minisystem/880/README.md

SYSTEM80 880
======================================

Analogue drum machine in Eurorack format. Currently under development.

Hardware design by Minisystem: info@system80.net

LICENSE
=======
cc by-nc-sa
https://creativecommons.org/licenses/by-nc-sa/4.0/
