minisystem/880/Manual/Page 15 - Specifications.pdf

Specifications | 15

## Rhythm Memory

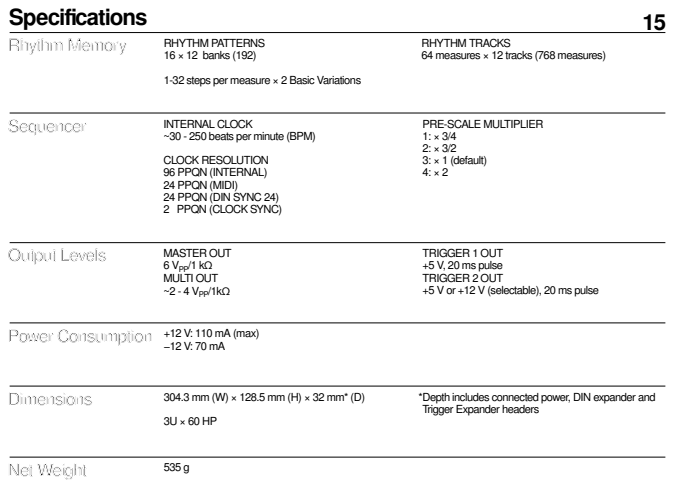
[picture p1: page 1]
Dimensions; Net Weight; Output Levels; MASTER OUT; 6 VPP/1 kΩ MULTI OUT ~2 - 4 VPP/1kΩ; Sequencer; INTERNAL CLOCK; PRE-SCALE MULTIPLIER 1: × 3/4 2: × 3/2 3: × 1 (default) 4: × 2

RHYTHM PATTERNS
16 × 12 banks (192)
1-32 steps per measure × 2 Basic Variations

RHYTHM TRACKS
64 measures × 12 tracks (768 measures)

~30 - 250 beats per minute (BPM)
CLOCK RESOLUTION
96 PPQN (INTERNAL)
24 PPQN (MIDI)
24 PPQN (DIN SYNC 24)
2 PPQN (CLOCK SYNC)

TRIGGER 1 OUT
+5 V, 20 ms pulse
TRIGGER 2 OUT
+5 V or +12 V (selectable), 20 ms pulse

Power Consumption +12 V: 110 mA (max)

epth includes connected power, DIN expander and
Trigger Expander headers
