minisystem/880/Panel/Panel_2.0_mechanical_r2000.dxf

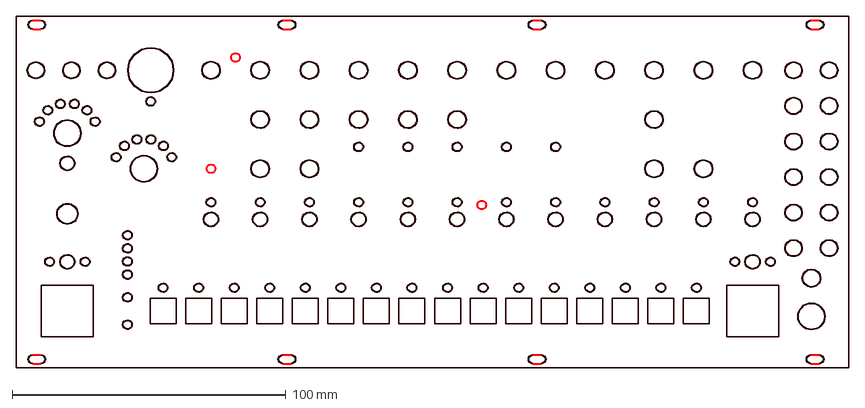
[picture p2: CAD file, 2017-06-20]
Panel/Panel_2.0_mechanical_r2000.dxf
304.3 x 128.5 mm
