minisystem/880/Panel/Panel_2.0_mechanical_r12.dxf

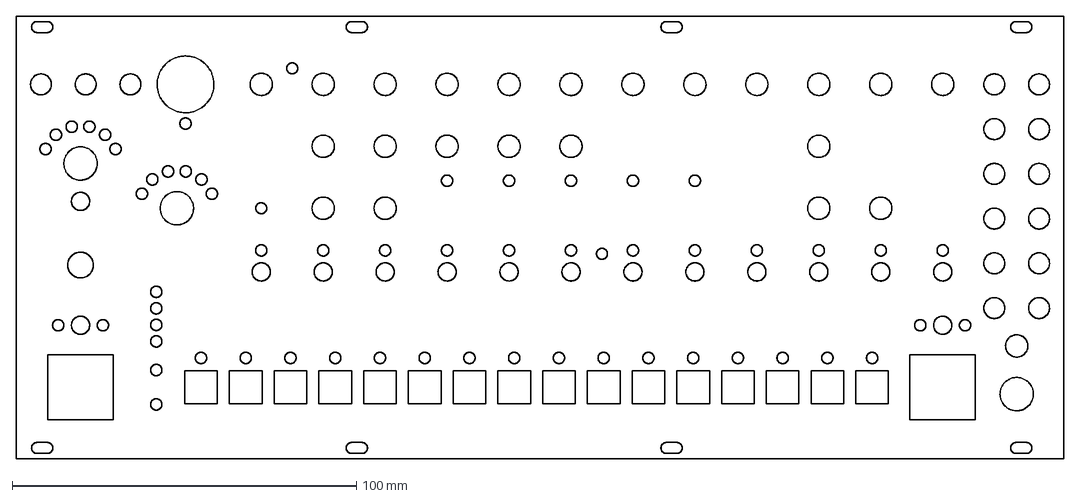
[picture p3: CAD file, 2017-06-20]
Panel/Panel_2.0_mechanical_r12.dxf
304.3 x 128.5 mm
