minisystem/880/Panel/Panel_2.0_mechanical.dxf

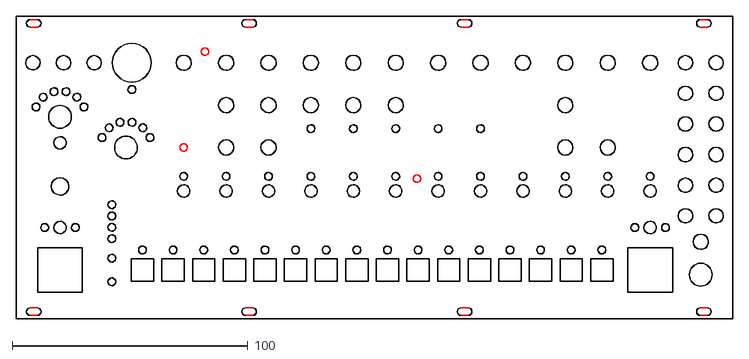
[picture p4: CAD file, 2016-09-16]
Panel/Panel_2.0_mechanical.dxf
304.3 x 128.5
