minisystem/880/Panel/79logo.dxf

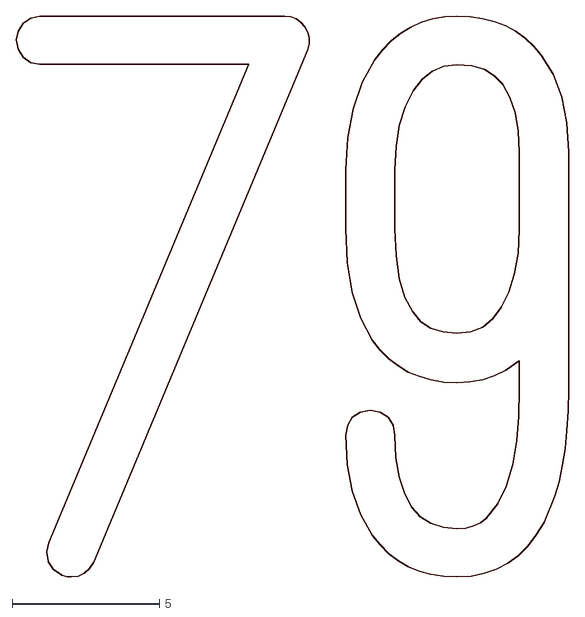
[picture p5: CAD file, 2016-09-08]
Panel/79logo.dxf
18.7 x 19.0
