minisystem/880/Panel/Panel 2.0 alignment template.dxf

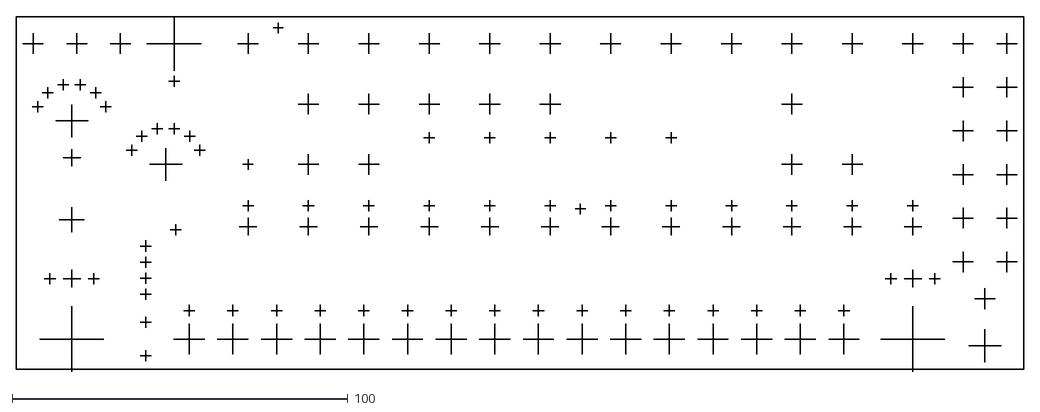
[picture p6: CAD file, 2016-09-03]
Panel/Panel 2.0 alignment template.dxf
300.0 x 105.8
