minisystem/880/Panel/Rhythm_composer_text.dxf

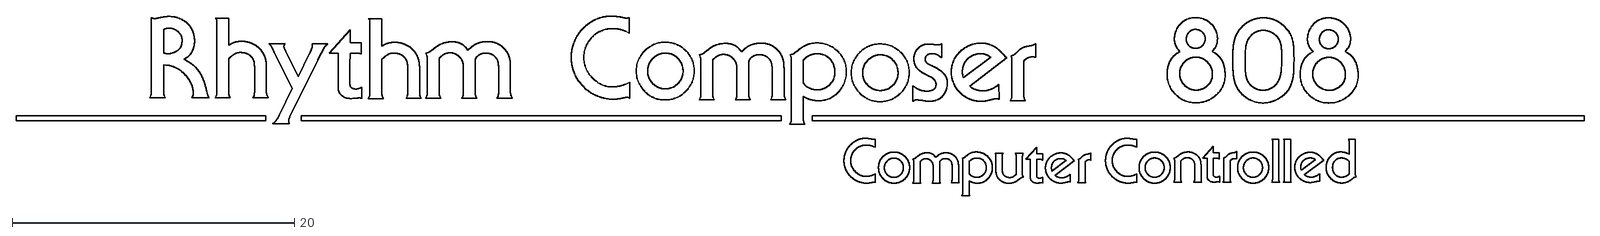
[picture p7: CAD file, 2016-09-03]
Panel/Rhythm_composer_text.dxf
111.1 x 12.7
