minisystem/880/Panel/Panel Template for import into Kicad.dxf

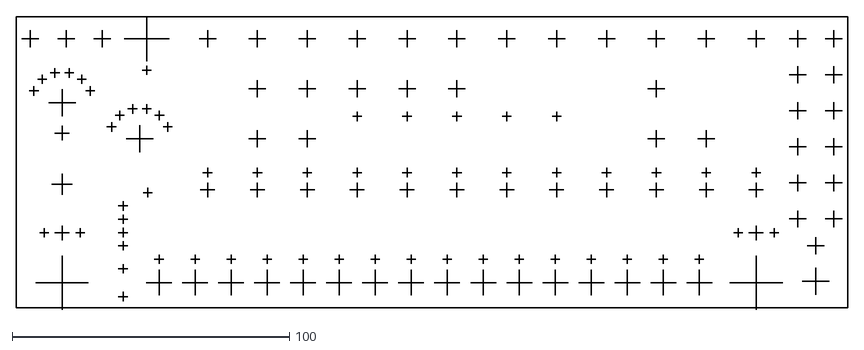
[picture p8: CAD file, 2016-07-31]
Panel/Panel Template for import into Kicad.dxf
300.0 x 105.8
