minisystem/880/Manual/Page 5 - Quick Tips.pdf

## Quick

Tips | 5
This section gives a quick overview of some of the enhanced features that are specific to the 880. If you are unfamiliar with how a TR-series step sequencer

## Change the MIDI Channel

The 880's MIDI receive channel is set to Channel 1 by default. To change the default MIDI receive channel, use the MODE selector button to select CLEAR mode. With the sequencer stopped, press and hold both the

SHIFT-WRITE/NEXT key and the ALT key. Use the STEP buttons to select the MIDI receive channel, from 1 to 16.

## Assign the Trigger Outputs

## Alternate the Basic Variations

The BASIC-VARIATION button toggles between Variation A and Variation B. To alternate between A and B press and hold the SHIFT-WRITE/NEXT key while pressing the BASIC-VARIATION button. To exit the alternating mode simply press the BASIC-VARIATION button once.

functions please start on the next page, Control Descriptions, and refer back to this section once you are familiar with the 880's step sequencer functions.

## Change the Pattern Bank

Press and hold the ALT key and use the STEP buttons to select one of the 12 Pattern Banks available.
NOTE: In MANUAL PLAY mode the SHIFT-WRITE/

In Pattern Edit Mode (1st PART or 2nd PART) the current Rhythm Pattern can be changed while the

Press and hold both the SHIFT-WRITE/NEXT key and the ALT key and select the desired Rhythm Pattern

The currently playing pattern will finish playing and the newly selected rhythm pattern will begin playing.

NEXT key needs to be used in combination with the ALT key to access the Pattern Banks.

The 880's two Trigger Outputs can be assigned to any of the 16 drum voices and the Accent trigger.
With the sequencer stopped, use the MODE selector button to select MANUAL PLAY. Use the I/F VAR switch to select Trigger 1 (A) or Trigger 2 (B). Press and hold the SHIFT-WRITE/NEXT key and the ALT key. While these keys are held the currently assigned trigger will be indicated by the Instrument/Track LEDs.

## Copy and Paste a Rhythm Pattern

In Pattern Edit mode (1st PART or 2nd PART), with the sequencer stopped, select the pattern you wish to copy. Press and hold the CLEAR button and then select a new pattern to copy to. Both VARIATION A and B will be copied to the destination pattern. Any pattern data in the destination pattern will be overwritten.

Use the Instrument/Track buttons to select the instrument you wish to assign to the Trigger Output. By default Trigger 1 is assigned to the Accent and Trigger 2 is assigned to the Cowbell. Trigger assignments are stored in non-volatile memory for recall after power off.

## Mute an Instrument

## Sync to an External Clock

## Copy Variation A to Variation B

In Pattern Edit mode (1st PART or 2nd PART), with Variation A set as the current variation, press and hold the CLEAR button and then press the BASIC-VARIAT-

ION button. The pattern data in Variation A will be copied to Variation B.

To mute an instrument, press and hold the SHIFT-WRITE/NEXT key and press the Instrument/Track selector button for the instrument you wish to mute. Press the selector button again to un-mute.

The 880 may be synced to external MIDI clock, DIN Sync24 clock or an analog clock pulse on the SYNC IN jack. Press the AUTO FILL IN selector button while holding down the SHIFT-WRITE/NEXT key to change the Synchronization Mode.

Refer to Synchronization on Page 12 for more information.
