minisystem/880/Manual/Page 9 - Playing Rhythm Patterns.pdf

## Manual Play

## Playing Rhythm

Patterns | 9
MANUAL PLAY mode is a performance mode that allows Rhythm Patterns to be selected and played in real time. Fill In rhythms can be programmed to play at intervals or manually using the TAP button.
With the sequencer stopped, press the MODE selector button to select MANUAL PLAY mode. The STEP buttons are divided into two groups, 12 BASIC RHYTHMs and 4 INTRO/FILLs. The currently selected BASIC RHYTHM will blink in time with the tempo and the currently selected INTRO/FILL LED will remain solid.
Press the START/STOP button. The sequencer will begin to play the selected BASIC RHYTHM pattern. While the sequencer is playing, select a new BASIC

RHYTHM pattern. When the current pattern finishes playing the new pattern will start to play. If you wish to change the current Pattern Bank, press and hold the SHIFT-WRITE/NEXT key and the ALT key and select one of the 12 Pattern Banks using the STEP buttons. NOTE: MANUAL PLAY mode is the only mode where the SHIFT-WRITE/NEXT key needs to be used in combination with the ALT key to change the Pattern Bank.
The BASIC VARIATION button can be used to select the desired rhythm variation, A or B. Hold the SHIFT-WRITE/NEXT key and press the BASIC VARIATION button to enter the alternating A-B mode.

## Adding Intros and Fill Ins

You may add an introductory Rhythm Pattern that plays only once after the sequencer starts and is then followed by the selected BASIC RHYTHM pattern. With the sequencer stopped, press the TAP button. The selected BASIC RHYTHM LED will become solid and the selected INTRO/FILL IN LED will flash. This indicates that the Intro pattern is active and will play before the BASIC RHYTHM pattern when the sequencer is started. To cancel the Intro function, press the TAP button again. The selected BASIC RHYTHM LED will begin flashing and the INTRO/FILL IN LED will remain solid.
A Fill In Rhythm Pattern can be inserted between the BASIC RHYTHM pattern manually or at a programmed number of measures. To manually insert a Fill In rhythm, set the AUTO FILL IN selector to MAN and start the sequencer. The currently selected BASIC RHYTHM will begin to play. While the sequencer is playing press the TAP button. The currently playing BASIC RHYTHM will finish and the selected INTRO/ FILL IN pattern will play once. Pressing the TAP button again before the Fill In pattern finishes will make it play again.
If the BASIC VARIATION mode is set to alternate between variation A and B then pressing the TAP button will replace the next variation with the Fill In rhythm pattern. For example, if variation A is playing and the TAP button is pressed, then the Fill In will replace the queued B variation and return to the A variation.

Normal variation sequence:

VAR A | VAR B | VAR A
Sequence with Fill In:
VAR A [TAP] | FILL IN | VAR A
The same holds true if the TAP button is pressed again to repeat the Fill In.
Normal variation sequence:
VAR A | VAR B | VAR A | VAR B
Sequence with Fill In:
VAR A [TAP] | FILL IN [TAP] | FILL IN | VAR B
Fill Ins can also be programmed to occur automatically by setting the AUTO FILL IN selector to the desired interval number. The Fill In rhythm Pattern can be programmed to play every 2nd, 4th, 8th, 12th and 16th measure, automatically. To cancel automatic Fill Ins, set the AUTO FILL IN selector to MAN.
An Intro or Fill In's BASIC VARIATION can be selected using the I/F VAR button.
NOTE: in all other modes the I/F VAR button functions as the ALT key. To access the ALT key function in MANUAL PLAY mode you must also press the SHIFT-WRITE/NEXT key.

## Auditioning Drum Hits

In MANUAL MODE the Instrument Selector buttons can be used to trigger the drum voices. This allows the different drum sounds to be audtioned to try out rhythms in real-time and can also be used to improvise over top of a currently playing Rhythm Pattern.
Live drum hits can only be triggered in MANUAL
MODE when Audition Mode is activated. To activate Audition Mode, press and hold the SHIFT/WRITE-NEXT key and press STEP 7 ([AUD]). The STEP 7 LED will light indicating that Audition Mode is active. You may now use the Instrument Selector buttons to trigger the drum voices.

The paired instruments are accessed by switching between the A and B INTRO/FILL IN mode. When the INTRO/FILL IN mode is set to A, the bottom row of instruments are triggered and when the INTRO/FILL IN mode is set to B, the top row of instruments are triggered.
When Audition Mode is active, you lose the ability to select the current instrument for rolls. To disable Audtion Mode, press and hold the SHIFT/WRITE-NEXT key and press STEP 7 again to disable drum auditioning.
