minisystem/880/Manual/Page 17 - Operation Reference.pdf

Operation Reference | 17

## Rhythm Pattern Programming

### 1 With the sequencer stopped, set the MODE selector to

PATTERN CLEAR.

2
Press the BASIC VARIATION button to select Variation A or Variation B. ³
Press the CLEAR button.
Set the MODE selector to 1st PART.

4

Start the sequencer by pressing the START/STOP button.

5

6
While pressing the SHIFT/WRITE-NEXT key, press the CLEAR button to choose the PRE-SCALE. ⁷
While pressing the CLEAR button, press a STEP button to set the desired pattern length (1-16)*. ⁸
Choose an instrument using the INSTRUMENT/TRACK selector buttons. ⁹
Press the STEP buttons to program the instrument on the desired steps. ¹⁰
Program the other instrument sounds and ACCENT by repeating and . 9 10 11
Press the START/STOP button when programming has been completed.

## Manual Play

1

### 2 Use STEP buttons 1-12 to select the Basic Rhythm

Pattern you want to play.

3

4

Set the MODE selector to MANUAL PLAY.

Press the BASIC-VARIATION button to select the Variation you want to play, A or B.

## Intro

Use STEP buttons 13 - 16 to select the Intro Rhythm Pattern you want to play. ¹

2
3 Press the TAP button to activate the Intro.

## Fill In (MANUAL)

1 Set the AUTO FILL IN selector to MAN.

4

Press the I/F - VAR button to select the Intro variation.

3 Press the I/F - VAR button to select the Fill In variation.

### 4 Press the TAP button when you want the Fill In Rhythm

Pattern to play instead of the BASIC RHYTHM.

### 2 Use STEP buttons 13 - 16 to select the Fill In Rhythm

Pattern you want to play.

Start the sequencer by pressing the START/STOP button.

Start the sequencer by pressing the START/STOP button.

12

Use the STEP buttons to select the Rhythm Pattern memory location you wish to program.

In the case of programming 16 steps setting the pattern length is unnecessary.

*

## Fill In (AUTOMATIC)

### 1 Choose the Fill In count using the AUTO FILL IN selector

(16, 12, 8, 4, or 2 measures).

3 Press the I/F - VAR button to select the Fill In variation. 4 Press the START/STOP button to start the sequencer.

### 2 Use STEP buttons 13 - 16 to select the Fill In Rhythm

Pattern you want to play. Track Compose

1

### 2 Choose the Track with the INSTRUMENT/TRACK

selector buttons.

3

4

Set the MODE selector to COMPOSE

Use the STEP buttons to select the first Rythm Pattern of the Track.

## Track Play

1 Set the MODE selector to PLAY.

2

3

4

Choose the Track to play using the INSTRUMENT/ TRACK selector buttons.

Start the sequencer by pressing the START/STOP button.

Press the BASIC VARIATION button to select Variation A or Variation B. ⁵
6 Press the START/STOP button to start the sequencer. Press the SHIFT-WRITE/NEXT key to advance to the next measure. ⁷
Use the STEP buttons to select a different Rythm Pattern, if desired. Press the SHIFT-WRITE/NEXT key to save the Rhythm Pattern and advance to the next measure.

8

9

Press the CLEAR button.

At the last measure of the composition, stop the sequencer by pressing the START/STOP button.

Press the BASIC VARIATION button to select Variation A or Variation B.
