minisystem/880/Manual/Page 18 - Back Cover.pdf

## SYSTEM80

Toronto, Ontario, Canada

System80 Inc.
