minisystem/880/Manual/Page 16 - Warranty.pdf

Warranty | 16

## Contact

Open Source | The 880 is open source hardware and the firmware is open source software. This means the complete design is available for non-commerical use. If your 880 ever requires an out-of-warranty repair, the design files
Warranty | Your 880 is guaranteed to be free from manufacturing defects for 1 YEAR from the date of purchase. At our sole discretion we will replace or repair your unit if we find it to be defective (transport charges may apply). NOTE: the 880's panel is screenprinted in 3 colours of

Do not hesitate to contact System80 with any questions or concerns about your 880. The 880 began as a passion project with the aim of making a small recreation of the TR-808 in Eurorack with as few compromises as possible. It was a lot of fun to design, prototype, and test. We hope that it will inspire you for many years.

durable epoxy-based ink. It is a 5 step process that is performed manually. Being a hand crafted product, you may notice very small blemishes or defects upon close inspection. These are unavoidable and inherent to the manual painting and screenprinting process.

YouTube, and Muffwiggler, these are not the best ways to reach us with questions or concerns about your 880. We endeavor to respond to email inquiries within 48 hours of receiving them.

Please contact us by email:
info@system80.net
While System80 has a regular presence on social media sites such as Facebook, Instagram, Twitter,

should allow a local qualified technician to perform any repair or modification.

www.github.com/minisystem/880
