minisystem/880/880_main.pdf

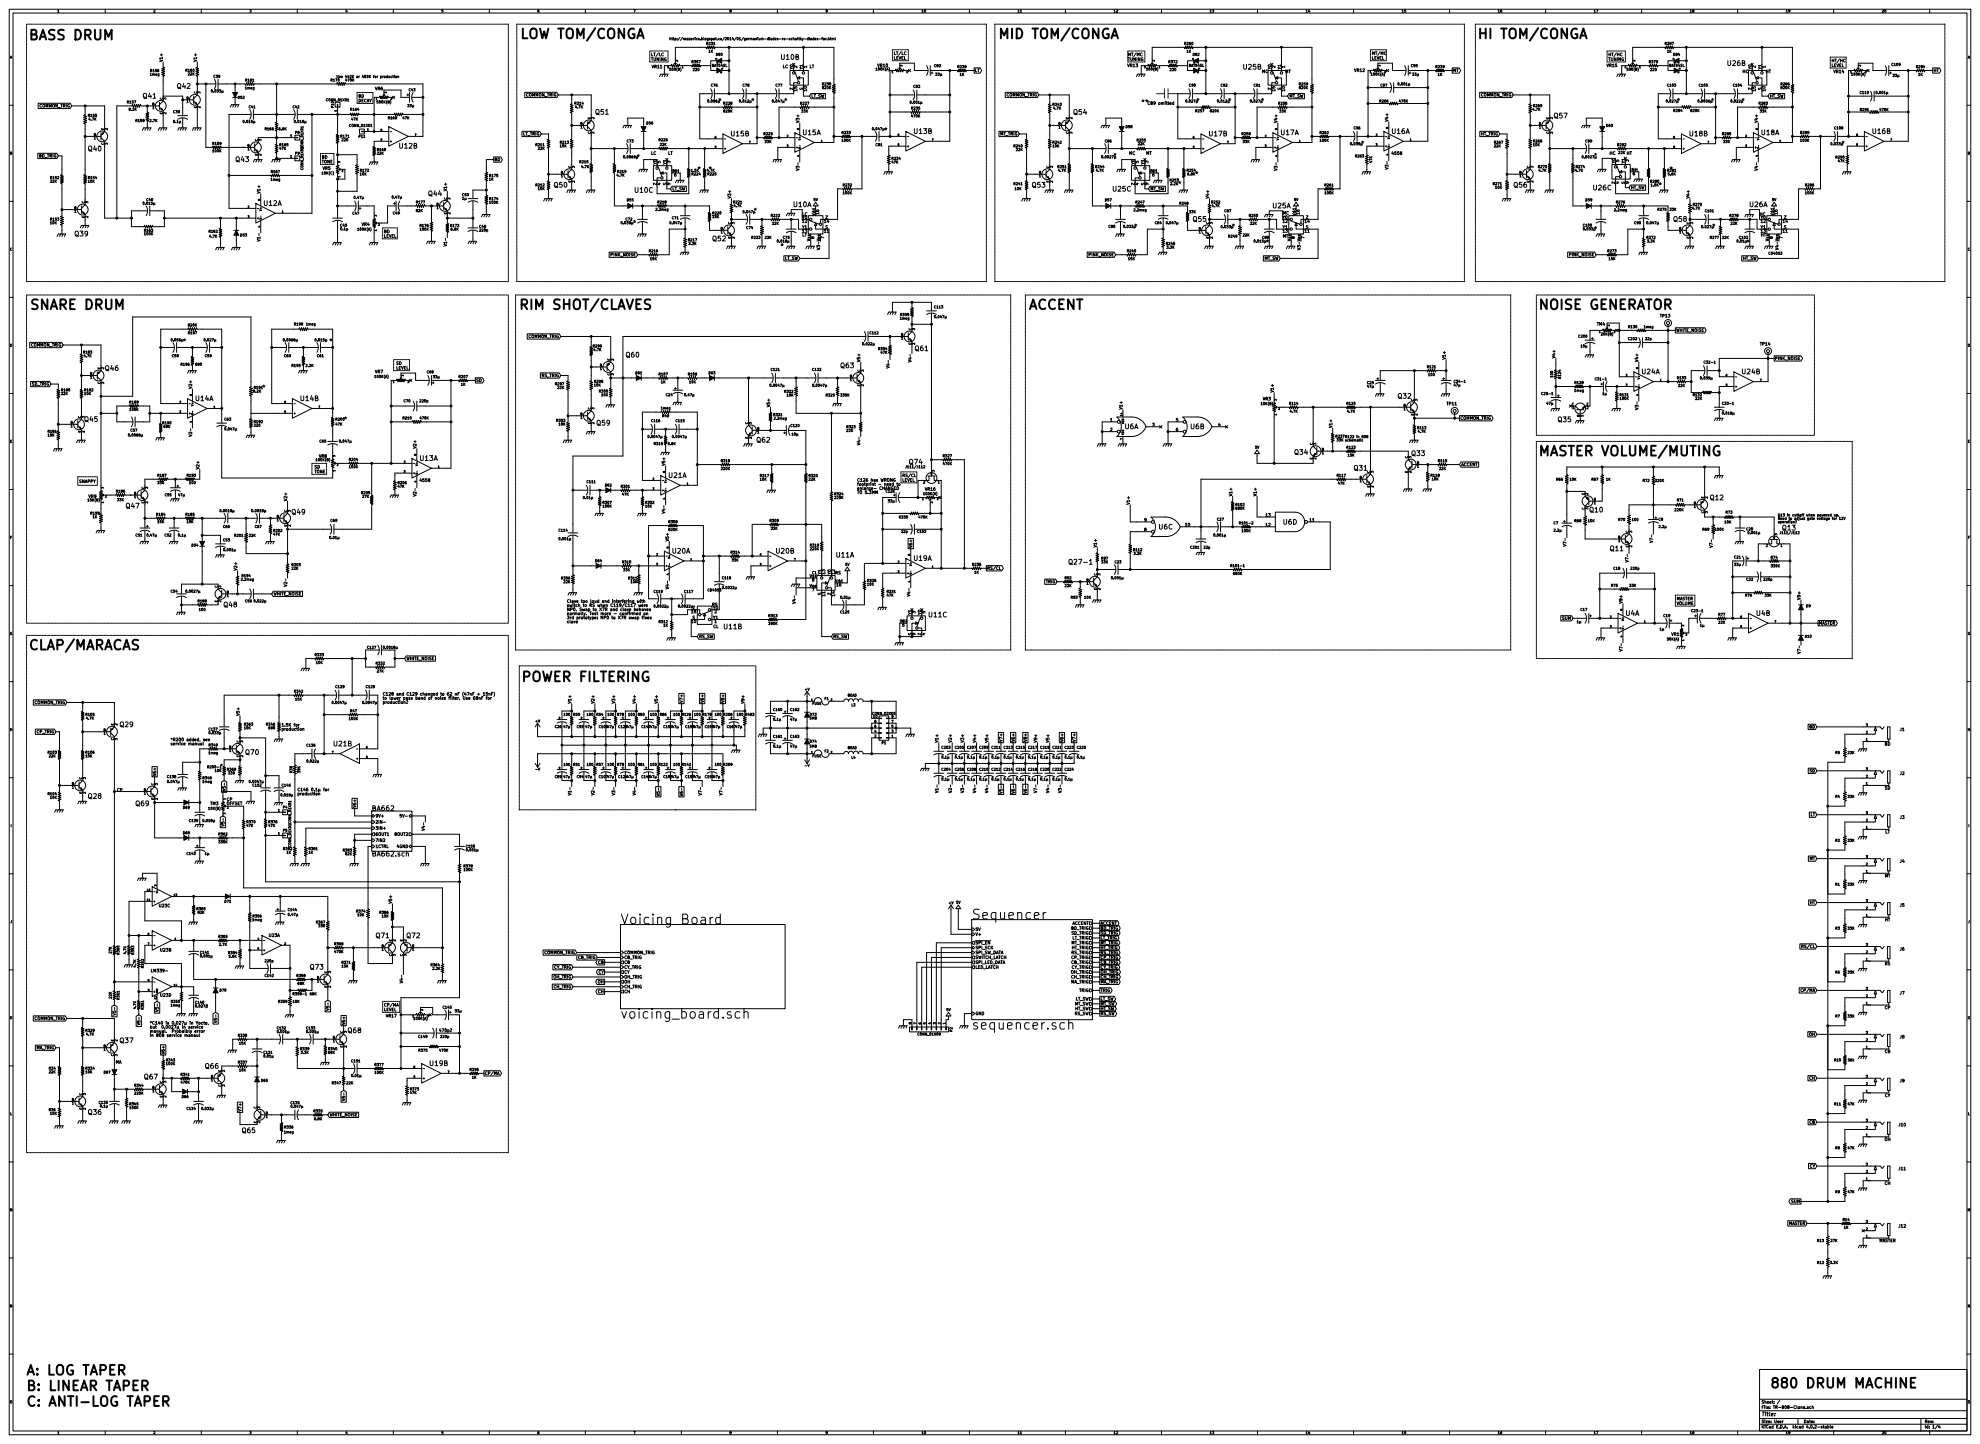
[picture p11: page 1]

Use 442K or 453K for production

Q13 in cuttoff when powered up.
Need to adjust gate voltage for 12V
operation?

Clave too loud and interfering with
switch to RS when C119/C117 were
NP0. Swap to X7R and clave behaves
normally. Test more - confirmed on
3rd prototype: NP0 to X7R swap fixes
clave

to lower pass band of noise filter. Use 68nF for
production?

*C140 is 0.027 in Yocto, but 0.0027 in service manual. Probalbly error

Id: 1/4 Title: File: TR-808-Clone.sch Sheet: /
