minisystem/880/880_voicing.pdf

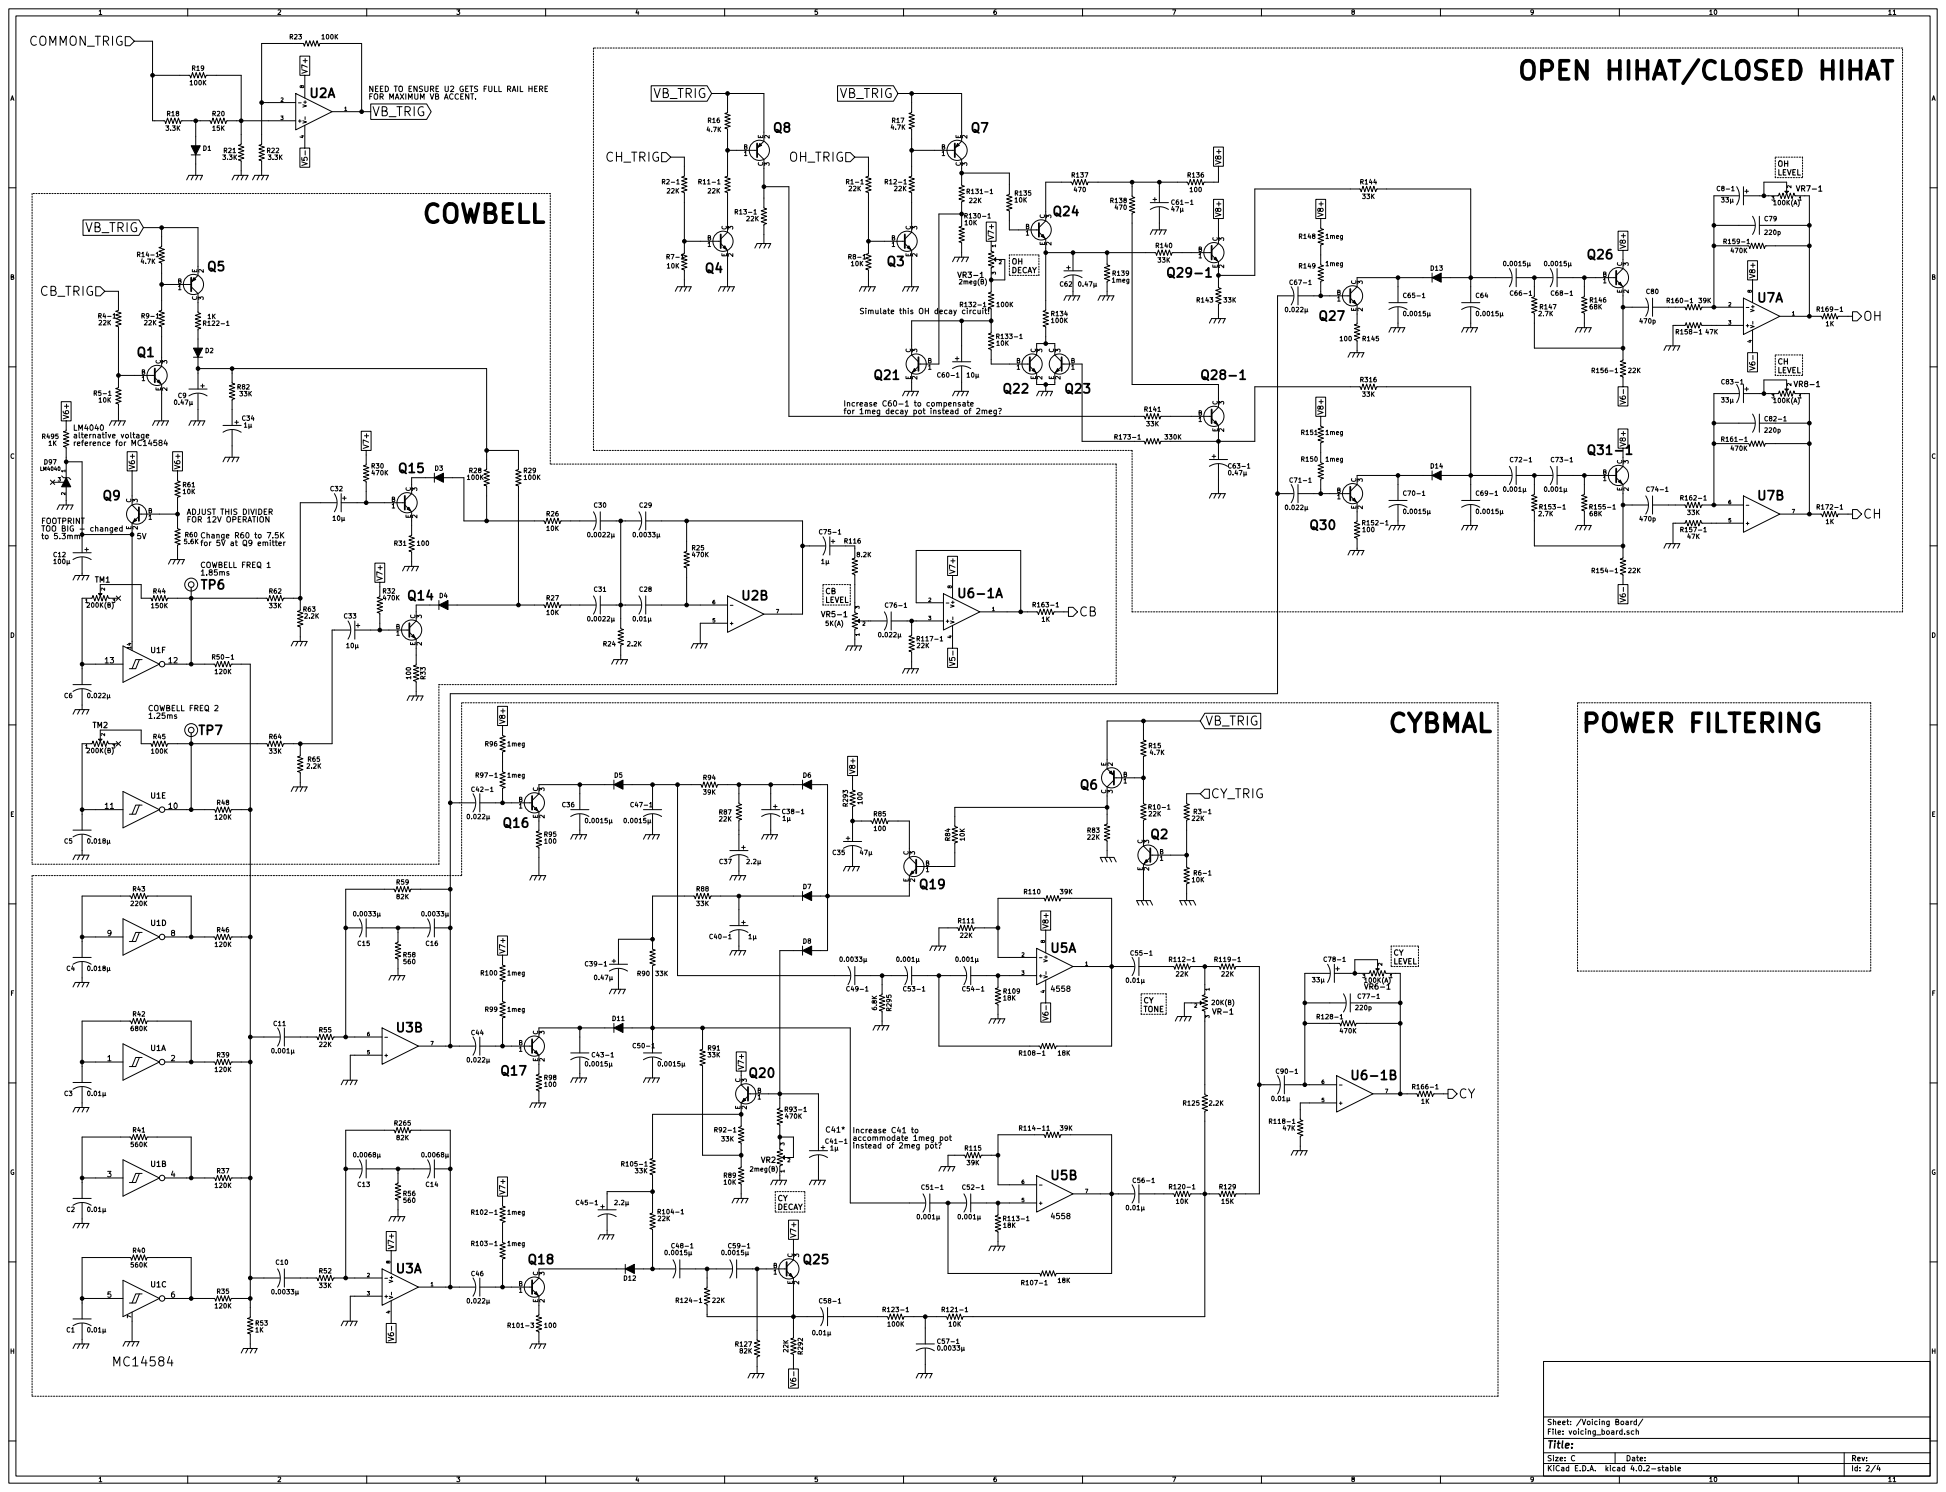
[picture p12: page 1]

OPEN HIHAT/CLOSED HIHAT

22K NEED TO ENSURE U2 GETS FULL RAIL HERE
FOR MAXIMUM VB ACCENT.

Simulate this OH decay circuit! R2-1

Increase C60-1 to compensate
for 1meg decay pot instead of 2meg?
