minisystem/880/Manual/Page 2 - Front Panel Layout.pdf

## SYNC INPUT MIDI INPUT

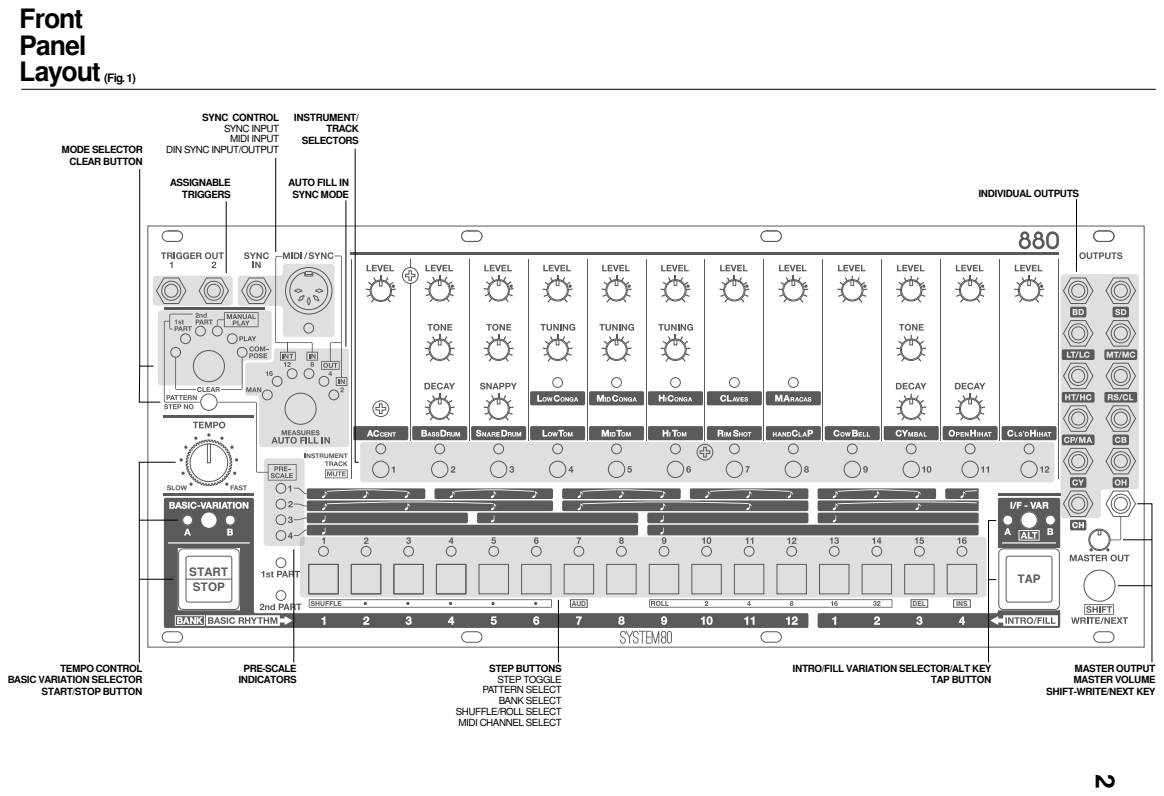
[picture p13: page 1]
(Fig. 1); AUD; DEL; INS; TAP START STOP; ASSIGNABLE TRIGGERS; MODE SELECTOR CLEAR BUTTON; INSTRUMENT/ TRACK SELECTORS; TEMPO CONTROL; PRE-SCALE INDICATORS; SYNC CONTROL; TAP BUTTON; INDIVIDUAL OUTPUTS; Front Panel Layout

DIN SYNC INPUT/OUTPUT

AUTO FILL IN
SYNC MODE

STEP BUTTONS
STEP TOGGLE
PATTERN SELECT
BANK SELECT
SHUFFLE/ROLL SELECT
MIDI CHANNEL SELECT

INTRO/FILL VARIATION SELECTOR/ALT KEY

MASTER OUTPUT
MASTER VOLUME
SHIFT-WRITE/NEXT KEY

BASIC VARIATION SELECTOR

START/STOP BUTTON
