minisystem/880/Panel/808-panel-April.pdf

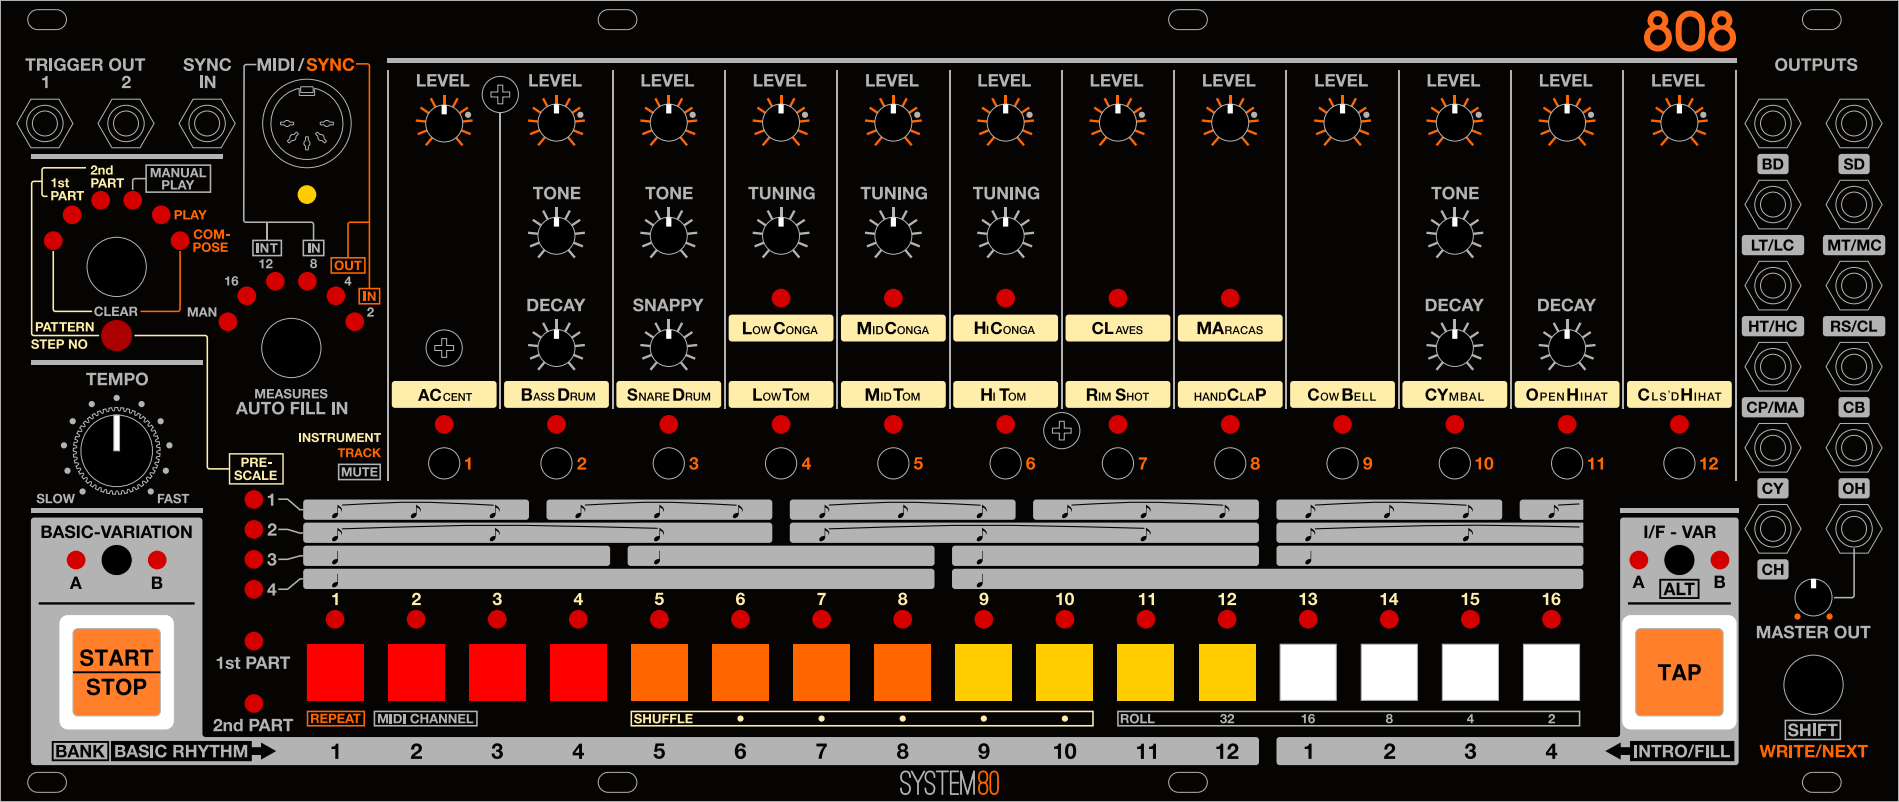
[picture p14: page 1]
