minisystem/880/Panel/Euro TR-808 Panel.pdf

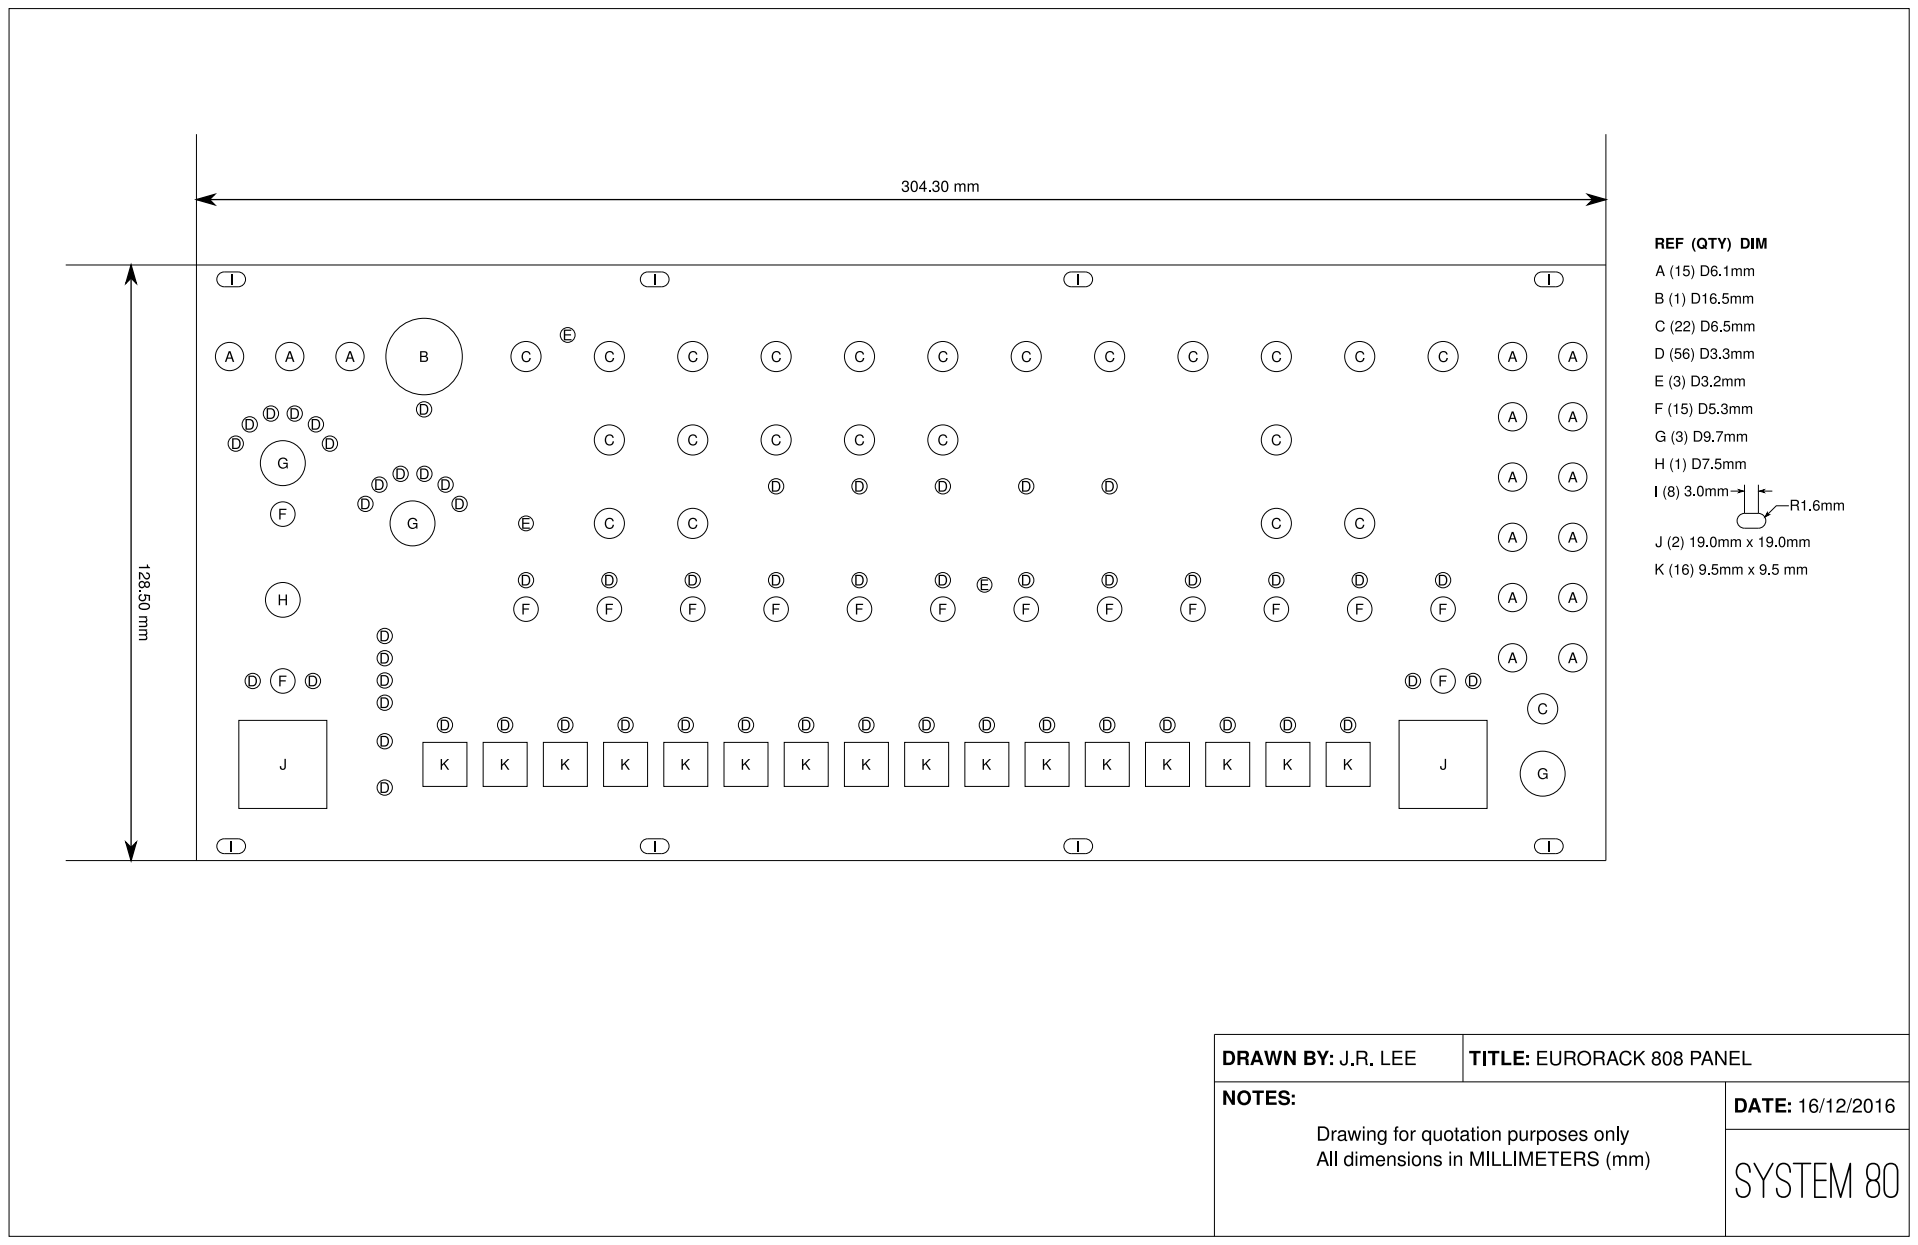
[picture p15: page 1]
