minisystem/880/Manual/Quick Guide - Inside - no fold lines.pdf

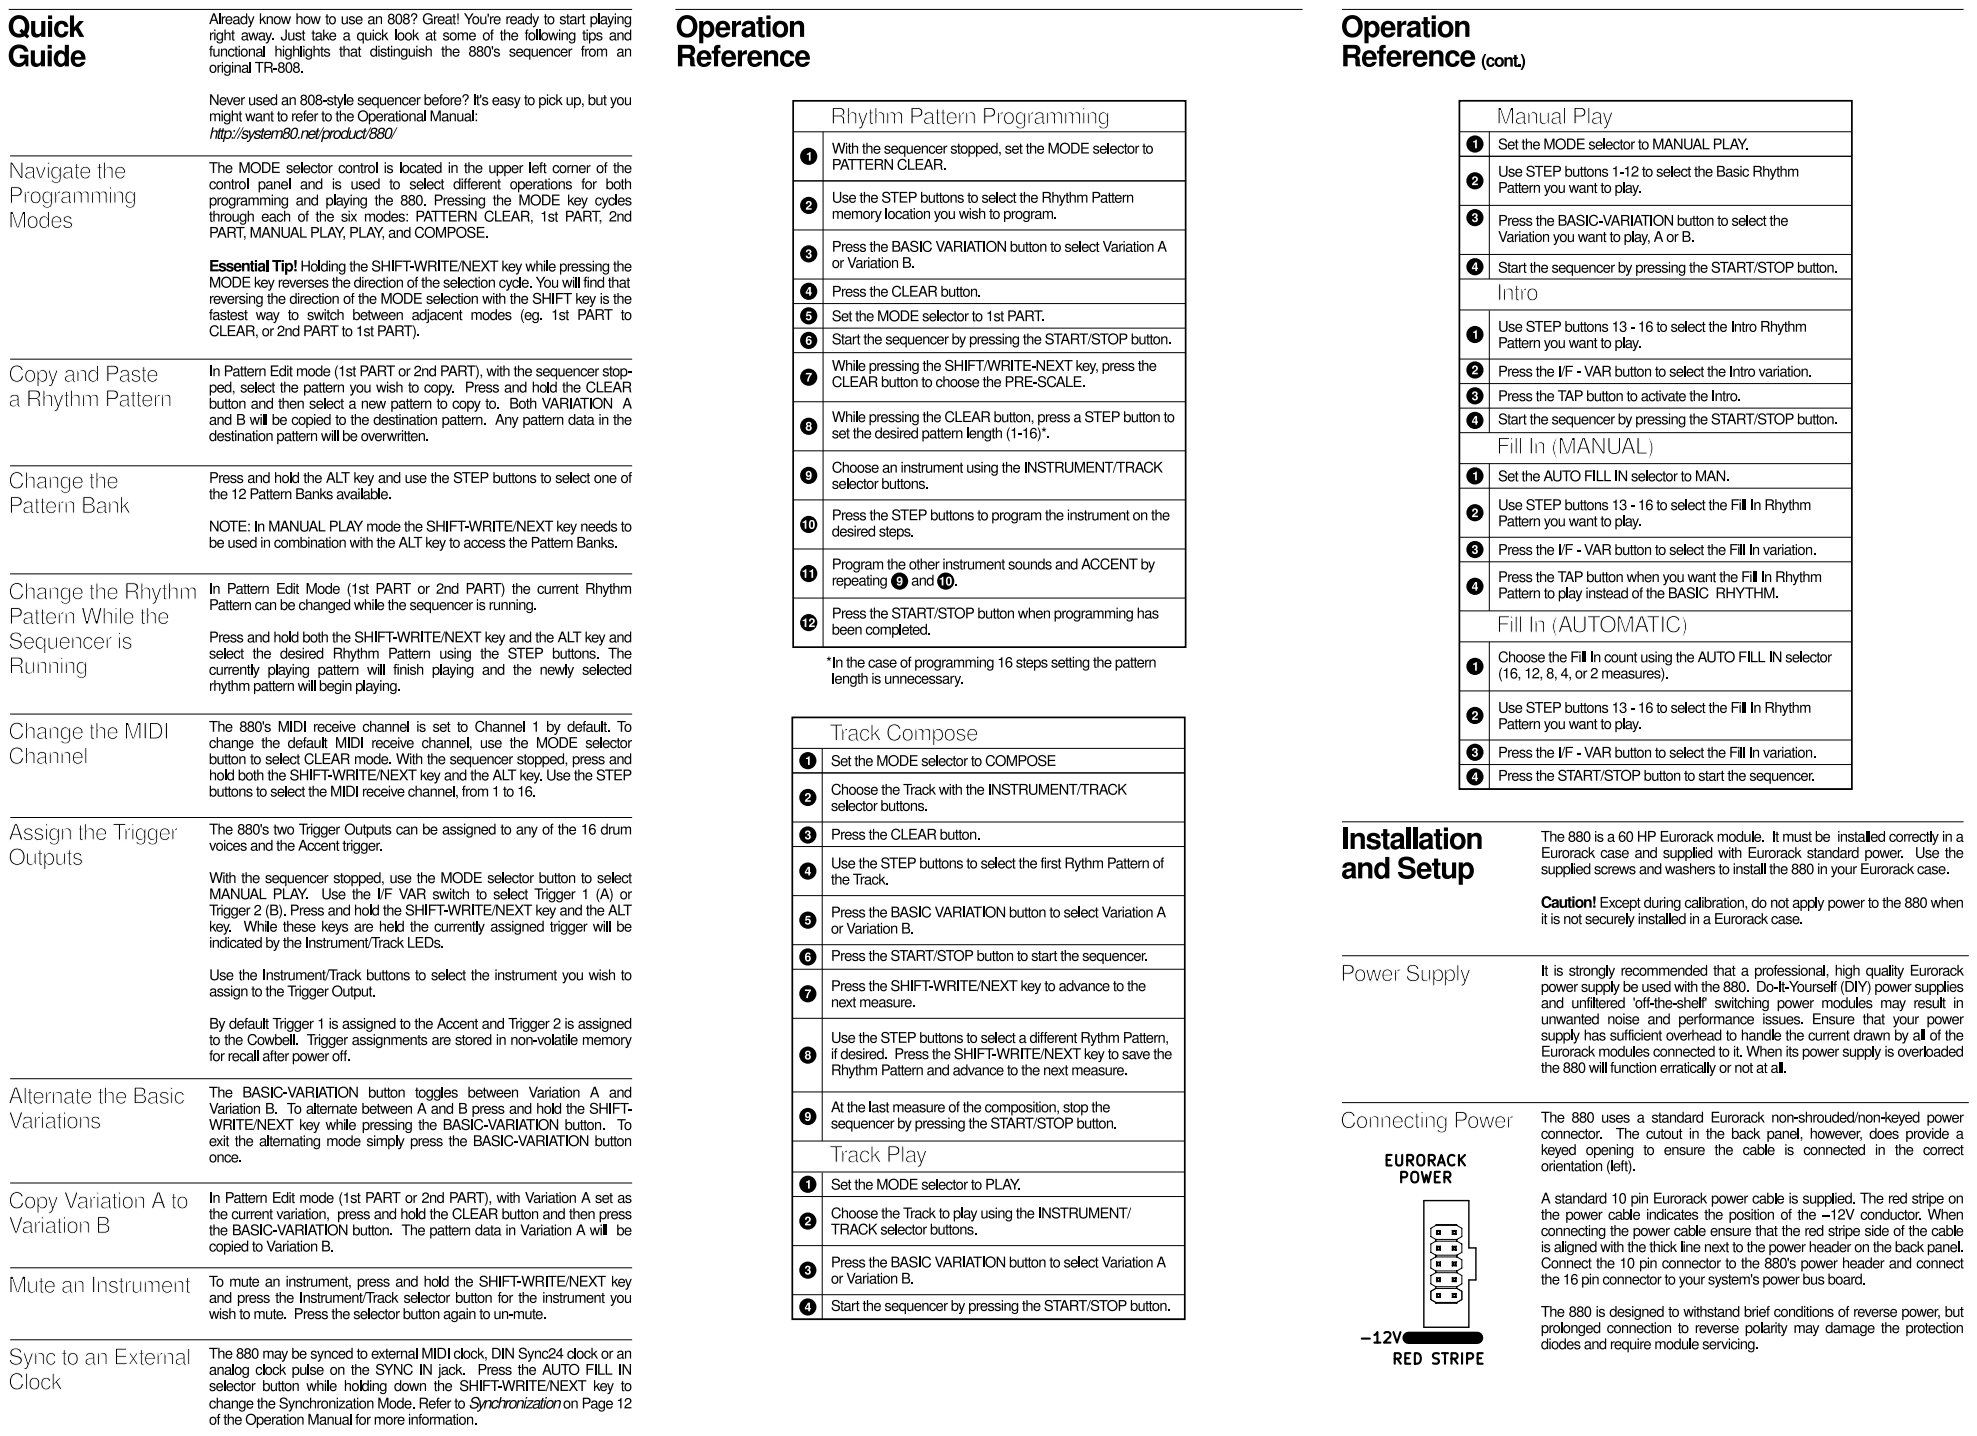
[picture p16: page 1]
