minisystem/880/Manual/Quick Guide - Inside.pdf

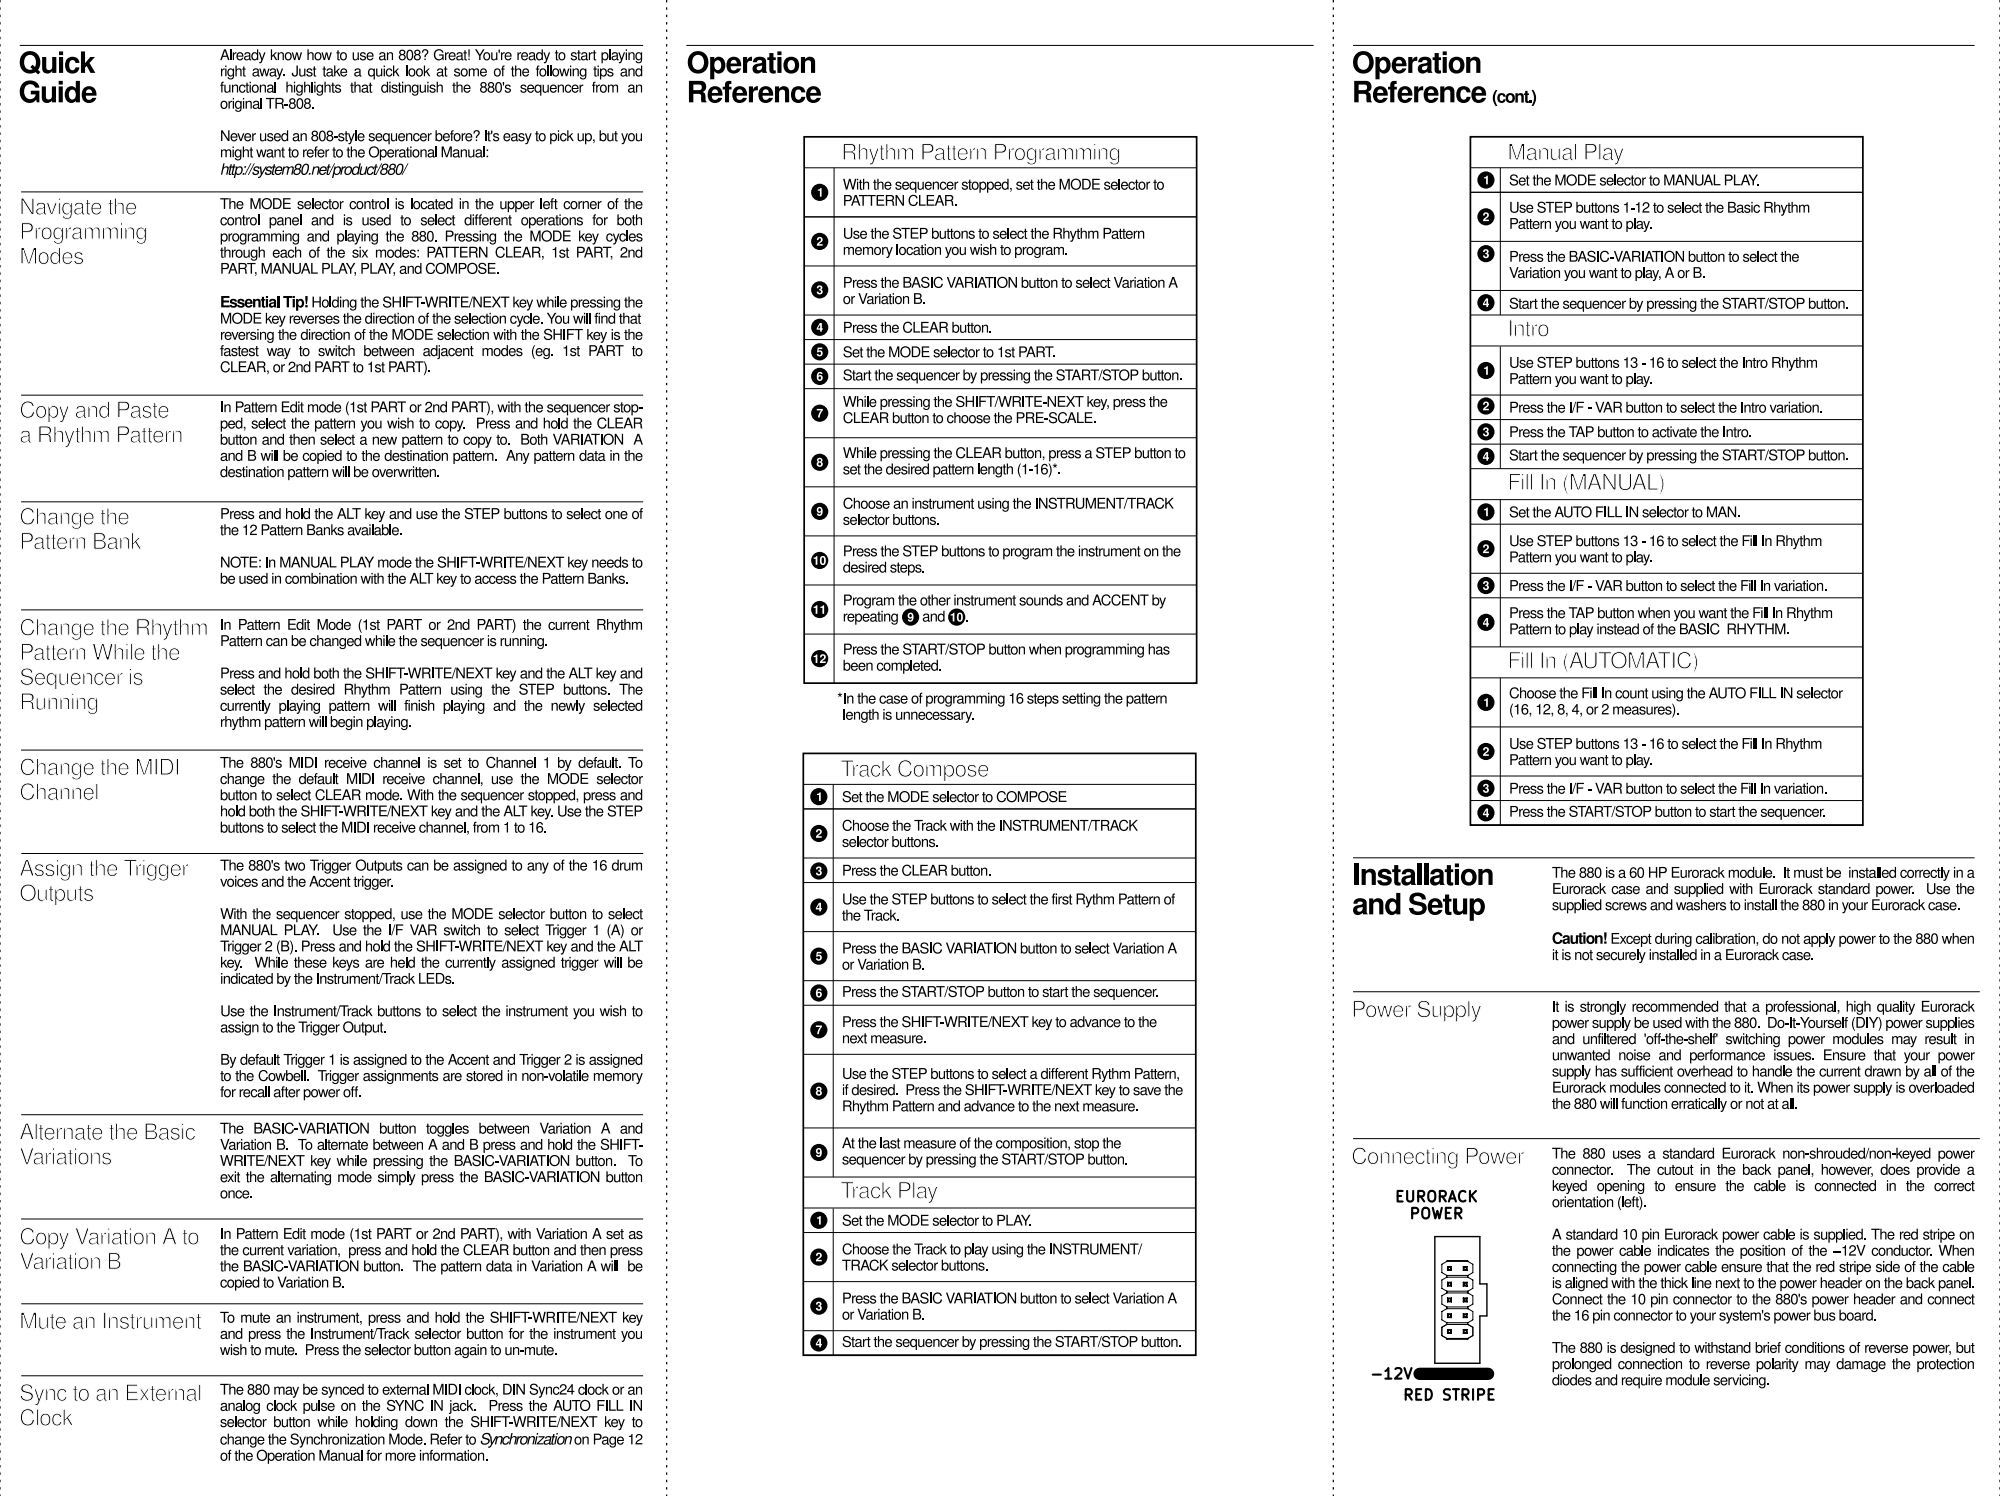
[picture p17: page 1]
