minisystem/880/Manual/Quick Guide - Outside - no fold lines.pdf

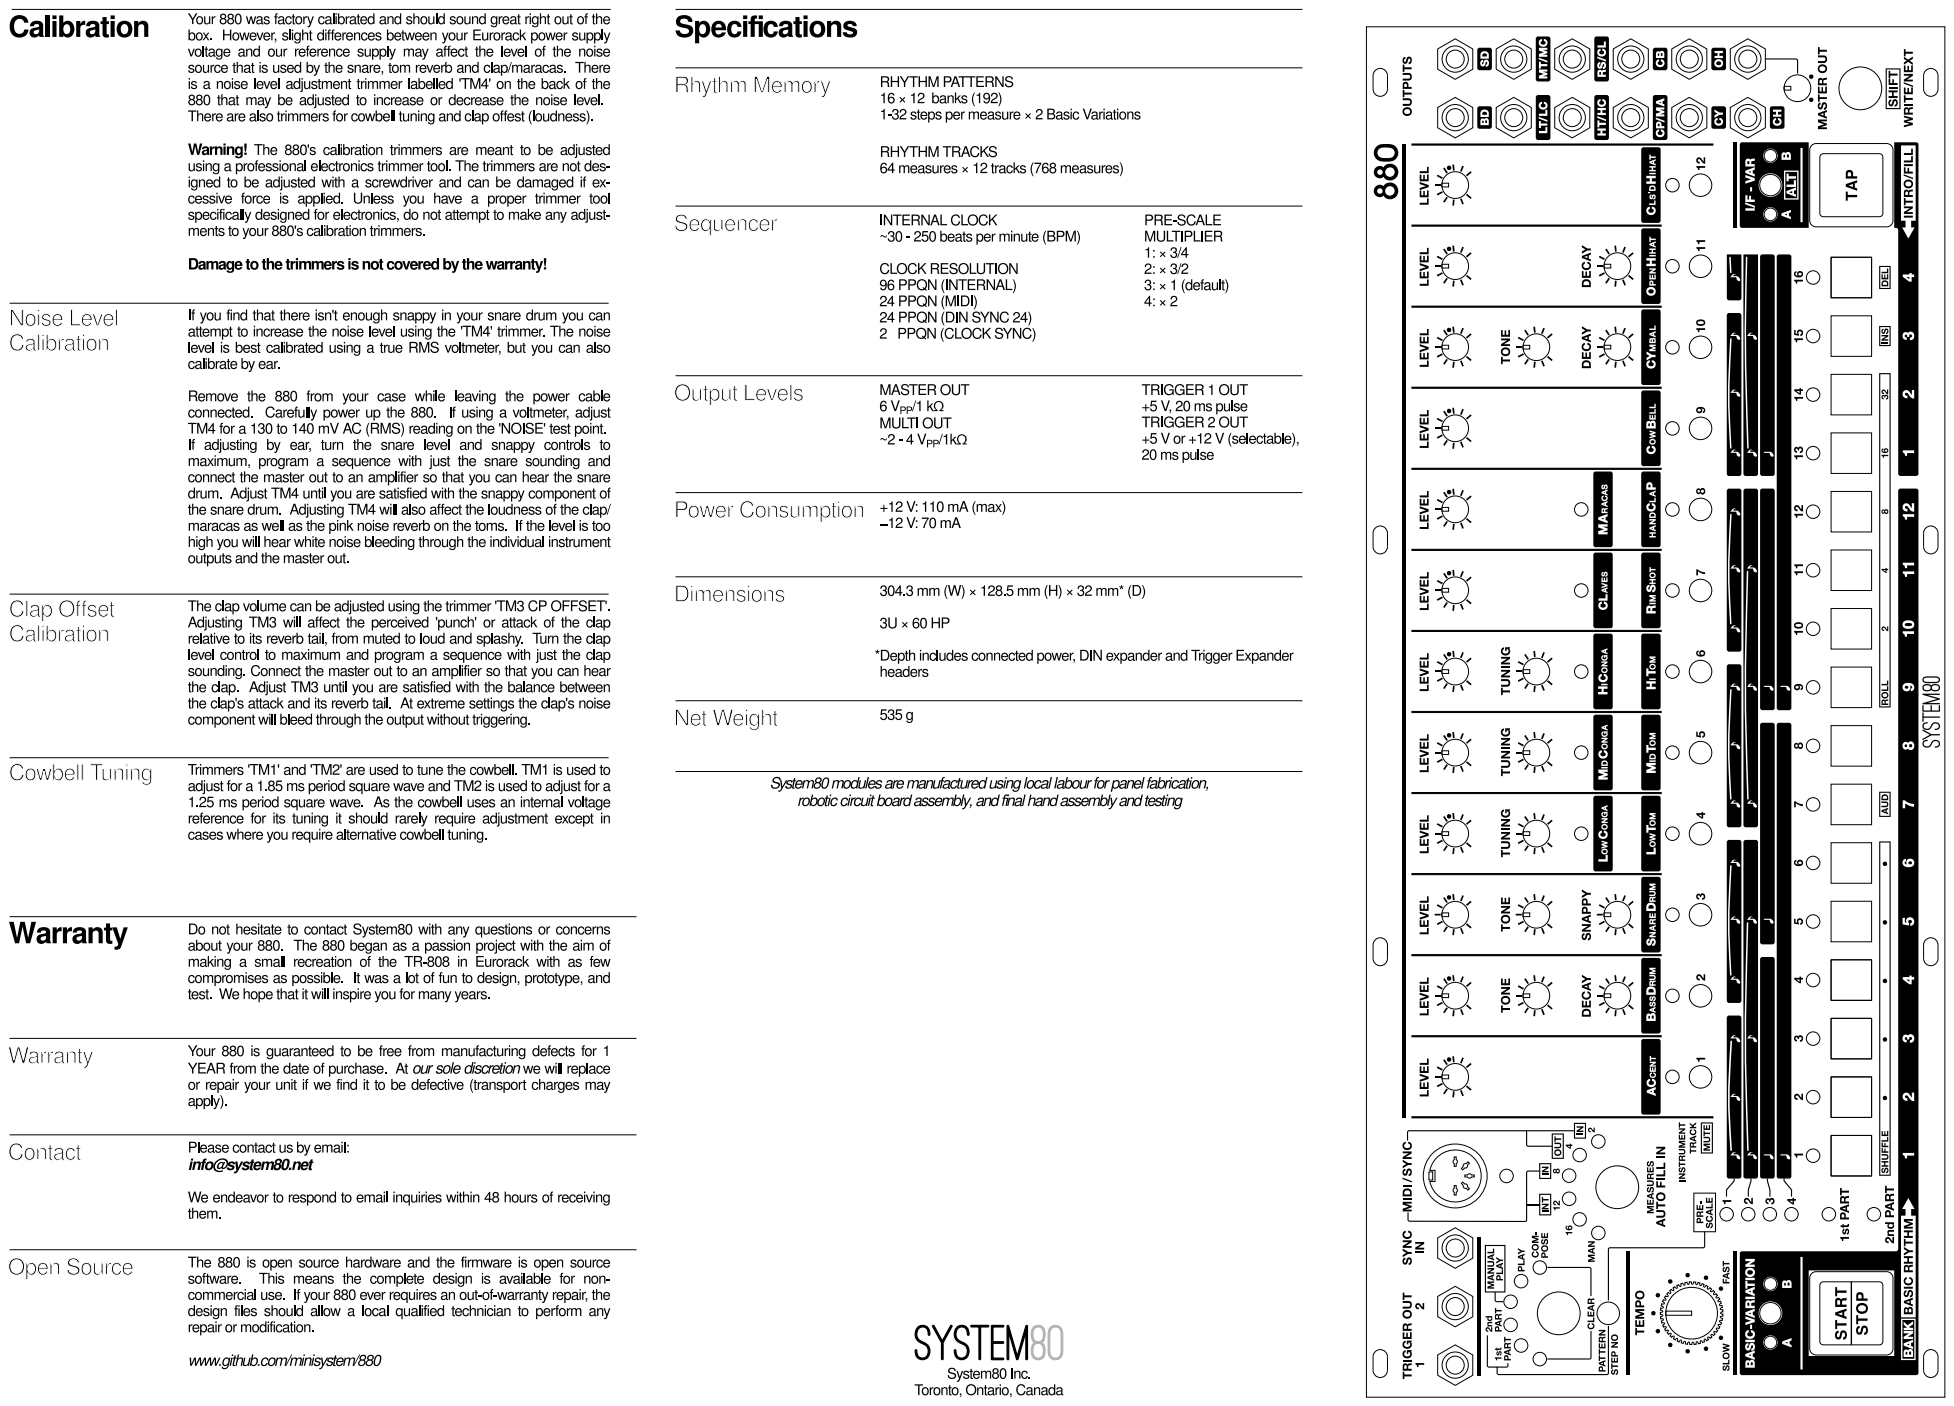
[picture p18: page 1]
