minisystem/880/Manual/Quick Guide - Outside.pdf

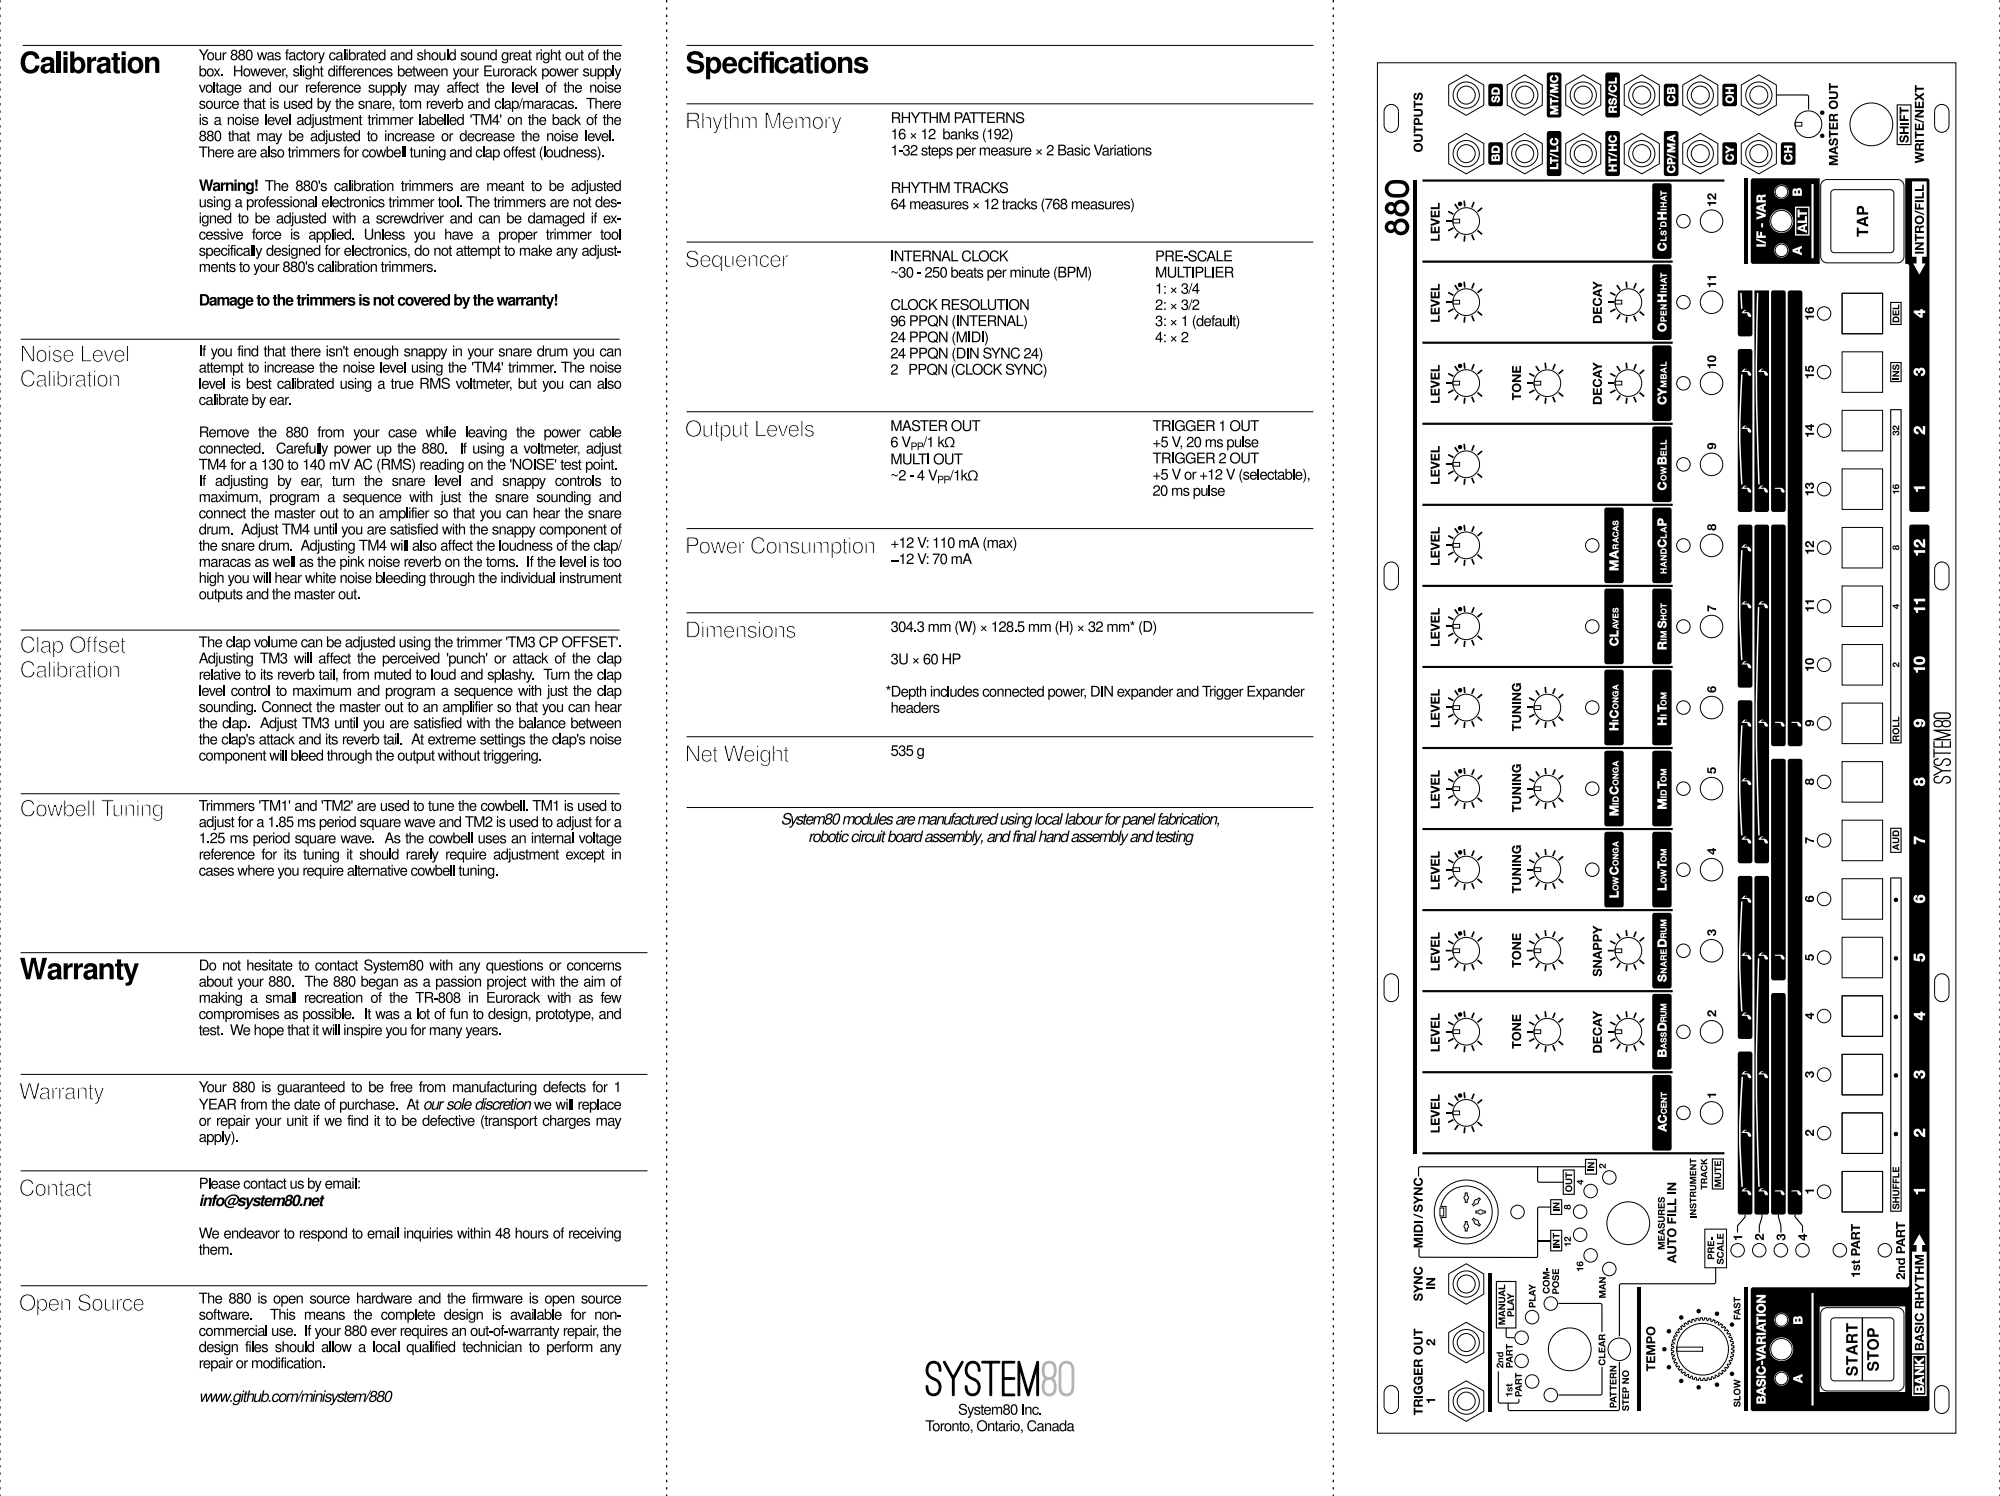
[picture p19: page 1]
