minisystem/880/Manual/Cover - Front.pdf

## Operation Manual

880

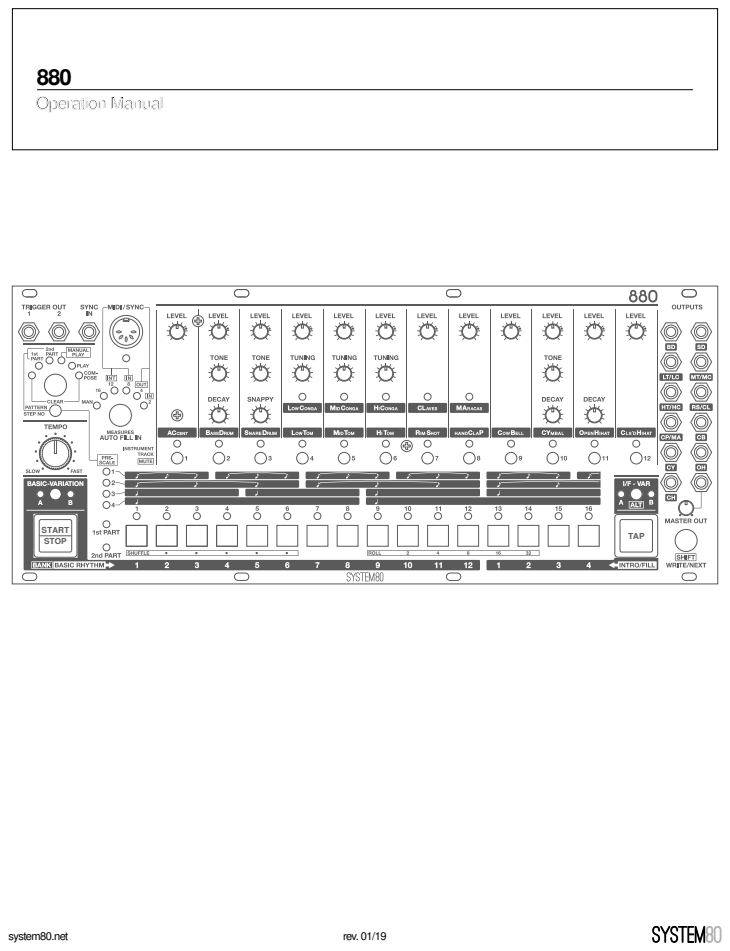
[picture p20: page 1]
system80.net; rev. 01/19; SYSTEM80; TAP START STOP
