minisystem/880/(commit log)

2016-01-03 working on low tom schematic
    [TR-808-Clone.sch]
2016-01-03 low tom schematic captured. 'reverb' pot added so DPDT switch can be used instead of harder to find 3PDT switch
    [TR-808-Clone.sch]
2016-01-04 toms finished, starting clap
    [TR-808-Clone.sch]
2016-01-06 working on clap
    [TR-808-Clone.sch]
2016-01-06 clap captured, finishing up maracas
    [TR-808-Clone.sch]
2016-01-06 maracas done. double check then move on to rimshot/claves
    [TR-808-Clone.sch]
2016-01-06 working on rim shot/claves now. should maybe consider trying heiarchical sheets for this, one for each drum circuit
    [TR-808-Clone.sch]
2016-01-07 finishing up RS/CL
    [TR-808-Clone.sch]
2016-01-07 rim shot/claves done
    [TR-808-Clone.sch]
2016-01-07 started voicing board schematic. schmitt trigger oscillator started
    [TR-808-Clone.sch]
2016-01-07 cowbell except for trigger input done
    [TR-808-Clone.sch]
2016-01-08 cowbell done, working on cymbal
    [TR-808-Clone.sch]
2016-01-08 working on cymbal
    [TR-808-Clone.sch]
2016-01-08 added voicing board heiarchical sheet
    [TR-808-Clone.sch, voicing_board.sch]
2016-01-08 Cymbal finished, about to start hats
    [TR-808-Clone.sch, voicing_board.sch]
2016-01-09 open and closed hats captured. Voicing board done.
    [TR-808-Clone.sch, voicing_board.sch]
2016-01-09 starting manual annoation to match original 808 schematic. Snare Drum annoation done
    [TR-808-Clone.sch]
2016-01-09 bass drum annoated
    [TR-808-Clone.sch]
2016-01-09 low tom/conga annotated
    [TR-808-Clone.sch]
2016-01-09 mid tom/conga and hi tom/conga annotated
    [TR-808-Clone.sch]
2016-01-09 rim shot/claves annotated
    [TR-808-Clone.sch]
2016-01-10 clap/maracas annotated
    [TR-808-Clone.sch]
2016-01-10 cowbell annotated
    [TR-808-Clone.sch, voicing_board.sch]
2016-01-10 cymbal annotated
    [TR-808-Clone.sch, voicing_board.sch]
2016-01-11 voicing board annotation complete. Still need to do master volume and mixer
    [voicing_board.sch]
2016-01-11 added accent
    [TR-808-Clone.sch]
2016-01-11 pot orientation checked and changed where necessary
    [TR-808-Clone.sch, voicing_board.sch]
2016-01-11 master volume and power on/off muting added
    [TR-808-Clone.sch, voicing_board.sch]
2016-01-14 individual outputs and master sum added
    [TR-808-Clone.sch]
2016-01-14 jack board annotated
    [TR-808-Clone.sch]
2016-01-15 added step switch board and sequencer sheets
    [TR-808-Clone.sch, sequencer.sch, step_switch_board.sch, voicing_board.sch]
2016-01-15 adding bits to sequencer
    [TR-808-Clone.sch]
2016-01-15 adding switches and LEDs, SPI interface
    [TR-808-Clone.sch, sequencer.sch, step_switch_board.sch]
2016-01-15 hairbrained scheme to combine MIDI IN/OUT + DIN IN/OUT in one socket...
    [sequencer.sch]
2016-01-15 connecting MIDI/DIN pins to MCU
    [sequencer.sch]
2016-01-15 updated ATMEGA328P to ATMEGA328PB. This is a newer MCU with slightly different pinout for VCC and GND. It's a little cheaper and has more timers
    [TR-808-Clone.sch, sequencer.sch, step_switch_board.sch, voicing_board.sch]
2016-01-15 SPI tweaking. Now two SPI busses. One for ISP, the other for switches and LEDs
    [sequencer.sch]
2016-01-16 more SPI work
    [sequencer.sch, step_switch_board.sch]
2016-01-16 connecting up sequencer to step switch board, tidying up
    [TR-808-Clone.sch, sequencer.sch, step_switch_board.sch]
2016-01-17 switch SPI set up, switches and LEDs given functional labels
    [sequencer.sch, step_switch_board.sch]
2016-01-17 boring power decoupling added. 808 has 100R and 47uF seperate decoupling/filtering for each drum voice.
    [TR-808-Clone.sch, sequencer.sch, voicing_board.sch]
2016-01-18 last commit before changing SPDT switches to 4053 CMOS switches
    [TR-808-Clone.sch, sequencer.sch]
2016-01-18 CD4053 SPDT switch implementatation started
    [TR-808-Clone.sch]
2016-01-18 CD4053 added to toms, clap and rim shot circuits to replace SPDT hardware switches
    [TR-808-Clone.sch]
2016-01-18 adding extra LEDs for instrument selector
    [TR-808-Clone.sch, sequencer.sch, step_switch_board.sch, voicing_board.sch]
2016-01-19 finished adding new LEDs. Could compress all SPI triggers and LEDs into 6 74HC595s instead of 7. Need to think more about layout to decide if this is worthwhile
    [sequencer.sch]
2016-01-20 adjustments to interface changes number of switches and LEDs in SPI network
    [sequencer.sch]
2016-01-20 housekeeping: groundng unused CMOS inputs, dealing with global and hiearchical labels
    [TR-808-Clone.sch, voicing_board.sch]
2016-01-20 last commit before auto annotation
    [TR-808-Clone.sch, step_switch_board.sch]
2016-01-21 entire project annotaed, duplicate references fixed with '-1' suffix
    [TR-808-Clone.sch, sequencer.sch, step_switch_board.sch, voicing_board.sch]
2016-01-21 adding CD4053 switch lines to SPI outputs
    [TR-808-Clone.sch, sequencer.sch, step_switch_board.sch, voicing_board.sch]
2016-01-21 ERC done, 7 warnings that check out
    [TR-808-Clone.sch, sequencer.sch, step_switch_board.sch]
2016-01-21 little bit of annotation clean up, ready to export netlist
    [TR-808-Clone.sch]
2016-01-21 netlist exported, starting footprint assignment
    [TR-808-Clone.sch, sequencer.sch, step_switch_board.sch, voicing_board.sch]
2016-01-21 all parts assinged except MIDI jack
    [TR-808-Clone.sch, sequencer.sch, step_switch_board.sch, voicing_board.sch]
2016-01-22 created PCB layout, added footprints
    [TR-808-Clone.sch, sequencer.sch, voicing_board.sch]
2016-01-22 placing pots and switches on grid
    [TR-808-Clone.kicad_pcb]
2016-01-23 placing switches and pots yo
    [TR-808-Clone.kicad_pcb]
2016-01-25 arranged LEDs around MODE and FILL buttons using polar coordinates
    [TR-808-Clone.kicad_pcb, TR-808-Clone.sch]
2016-01-25 more placement of electromechanical parts
    [TR-808-Clone.kicad_pcb]
2016-01-25 all electromechanical components placed. Placed ACCENT components, started placing BD components
    [TR-808-Clone.kicad_pcb, sequencer.sch]
2016-01-26 BD components placed, snare next
    [TR-808-Clone.kicad_pcb]
2016-01-27 snare circuit components placed
    [TR-808-Clone.kicad_pcb]
2016-01-28 starting to lay out low tom
    [TR-808-Clone.kicad_pcb]
2016-01-28 low tom placed
    [TR-808-Clone.kicad_pcb]
2016-01-28 tweaking of low tom placement, a few traces routed
    [TR-808-Clone.kicad_pcb]
2016-01-28 placing mid tom and hi tom
    [TR-808-Clone.kicad_pcb, TR-808-Clone.sch]
2016-01-29 added more test points for instrument triggers. started placing rim shot/claves
    [TR-808-Clone.kicad_pcb, TR-808-Clone.sch, sequencer.sch, step_switch_board.sch, voicing_board.sch]
2016-01-29 placing rim shot/claves and it's quite a pain in the butt
    [TR-808-Clone.kicad_pcb]
2016-01-29 further optimization of rim shot/clave component placement
    [TR-808-Clone.kicad_pcb]
2016-01-31 rim shot/claves components placed, tricky bits routed I think
    [TR-808-Clone.kicad_pcb]
2016-01-31 starting to place clap/maracas. tricky business
    [TR-808-Clone.kicad_pcb]
2016-02-01 still placing clap/maracas parts. still tricky
    [TR-808-Clone.kicad_pcb]
2016-02-01 clap/maracas components all placed
    [TR-808-Clone.kicad_pcb]
2016-02-01 starting CB/CY/HH placement
    [TR-808-Clone.kicad_pcb, voicing_board.sch]
2016-02-02 placed noise generator components, continuing to place Cymbal components
    [TR-808-Clone.kicad_pcb, TR-808-Clone.sch, sequencer.sch, step_switch_board.sch, voicing_board.sch]
2016-02-03 routing cowbell
    [TR-808-Clone.kicad_pcb]
2016-02-03 geting close to placing/routing Schmidtt trigger oscillator
    [TR-808-Clone.kicad_pcb]
2016-02-03 placed and routed CB/CY/HH 14584 oscillator
    [TR-808-Clone.kicad_pcb]
2016-02-03 cowbell components placed, partially routed, CB/CY/HH oscillator placed and routed, starting to place CY
    [TR-808-Clone.kicad_pcb]
2016-02-04 still placing CYmbal components. tricky and next step should be to place trigger in components
    [TR-808-Clone.kicad_pcb]
2016-02-04 quagmired in CYmbal. trickiest part yet
    [TR-808-Clone.kicad_pcb]
2016-02-04 damn CYmbal. pain in my butt. close to the end, but so far...
    [TR-808-Clone.kicad_pcb]
2016-02-05 need to rethink final mix and output stage of CYmbal. Very tricky to route now
    [TR-808-Clone.kicad_pcb]
2016-02-05 having a major rethink of placement for CYmbal
    [TR-808-Clone.kicad_pcb]
2016-02-05 slogging still. going to adjust placement of passives around U3
    [TR-808-Clone.kicad_pcb]
2016-02-06 cautiously optimistic that CYmbal is almost placed in a somewhat sensible way
    [TR-808-Clone.kicad_pcb]
2016-02-07 try doing this again but sober
    [TR-808-Clone.kicad_pcb]
2016-02-07 inching closer to victory or maybe dispair
    [TR-808-Clone.kicad_pcb]
2016-02-08 CYmbal components finally placed. It's a bit rough and ugly, but is placed and 90% routed with no vias. Phew. Clean it up a bit and move on to hi hats
    [TR-808-Clone.kicad_pcb]
2016-02-09 partially placed and routed OH and CH. About to reposition CH trigger circuit components
    [TR-808-Clone.kicad_pcb]
2016-02-09 OH and CH trigger circuitry is placed. Just envelope and final outputs to place.
    [TR-808-Clone.kicad_pcb]
2016-02-10 OH and CH components placed and mostly routed. Phew. Epic.
    [TR-808-Clone.kicad_pcb, voicing_board.sch]
2016-02-10 routed instrument outputs to jacks
    [TR-808-Clone.kicad_pcb]
2016-02-10 placed and routed master volume
    [TR-808-Clone.kicad_pcb]
2016-02-11 routing placed components
    [TR-808-Clone.kicad_pcb]
2016-02-11 more routing. bass drum needs some parts re-placed
    [TR-808-Clone.kicad_pcb]
2016-02-11 reworking bass drum component placement
    [TR-808-Clone.kicad_pcb, TR-808-Clone.sch]
2016-02-11 bass drum re-placed and routed
    [TR-808-Clone.kicad_pcb]
2016-02-11 accent circuit routed
    [TR-808-Clone.kicad_pcb]
2016-02-11 common trig and vb_trig routed
    [TR-808-Clone.kicad_pcb]
2016-02-12 added GH series low profile connector to connect step switch board to main board, added outline for step switch board, adjusted height of mainboard to 105 mm from 100 mm
    [TR-808-Clone.kicad_pcb, TR-808-Clone.sch, sequencer.sch, step_switch_board.sch, voicing_board.sch]
2016-02-12 placing and routing step switch board
    [TR-808-Clone.kicad_pcb]
2016-02-12 routing step switch board
    [TR-808-Clone.kicad_pcb]
2016-02-13 still routing step switch board. almost done
    [TR-808-Clone.kicad_pcb]
2016-02-14 mounting holes for step switch board placed
    [TR-808-Clone.kicad_pcb]
2016-02-14 starting to route power
    [TR-808-Clone.kicad_pcb, TR-808-Clone.sch, sequencer.sch, step_switch_board.sch]
2016-02-15 power routing
    [TR-808-Clone.kicad_pcb]
2016-02-15 slowly routing power
    [TR-808-Clone.kicad_pcb]
2016-02-16 power routed for drum voices. will need some tweaking when routing SPI lines
    [TR-808-Clone.kicad_pcb]
2016-02-16 rearranging LED SPI latches for ease of layout
    [TR-808-Clone.kicad_pcb, sequencer.sch]
2016-02-17 still more rearranging of LEDs to be done before routing SPI LED/TRIG lines
    [TR-808-Clone.kicad_pcb, sequencer.sch, step_switch_board.sch]
2016-02-17 more changes to LED SPI latch connections to facilitate routing. Slowly getting there
    [TR-808-Clone.kicad_pcb, sequencer.sch]
2016-02-17 still routing SPI lines. Almost done LED and TRIG and SW lines and can then move on to SPI switch reading
    [TR-808-Clone.kicad_pcb, sequencer.sch]
2016-02-18 routing SPI LEDs/TRIGs/SWs, almost done. Then onto switch input SPI latches
    [TR-808-Clone.kicad_pcb]
2016-02-18 routing remaining LED and switch lines. Need to reverse order of SCALE LEDs on PCB. Then onto SPI data/latch/clock lines
    [TR-808-Clone.kicad_pcb]
2016-02-19 added ground planes, routed MIDI/DIN SYNC lines, routing ISP SPI lines
    [TR-808-Clone.kicad_pcb]
2016-02-19 routing SPI data, latch and clock lines
    [TR-808-Clone.kicad_pcb]
2016-02-20 still routing SPI lines. What a pain in the bottom
    [TR-808-Clone.kicad_pcb]
2016-02-22 dear idiot: there are 23 resistors and capacitors in drum circuitry that have not been placed or routed. You are a total stupid dumb.
    [TR-808-Clone.kicad_pcb, sequencer.sch]
2016-02-22 so dumb. left too many unplaced/unrouted parts in analog section. really hard to place and route after the fact. dumbass
    [TR-808-Clone.kicad_pcb]
2016-02-22 recovered mostly from my earlier stupidity. Unplaced components in drum circuits placed after much buggering around. Still required 1 via.
    [TR-808-Clone.kicad_pcb]
2016-02-23 LED/TRIG latch SPI serial data lines routed, SPI_EN lines routed
    [TR-808-Clone.kicad_pcb, sequencer.sch]
2016-02-24 routing decoupling caps and stitching grounds
    [TR-808-Clone.kicad_pcb]
2016-02-24 deleted extra filter caps/resistors in Voicing Board power filtering section
    [TR-808-Clone.kicad_pcb, TR-808-Clone.sch, voicing_board.sch]
2016-02-24 77 connections left, mostly GND stitching. Changed all footprints with VRML1 models so can now use 3D viewer
    [TR-808-Clone.kicad_pcb]
2016-02-24 more 3D shape updating
    [TR-808-Clone.kicad_pcb]
2016-02-25 changed ground plane cleanance from 10 mil to 8 mil. Done this before, seems to be OK. Minimum clearance from fab house is 6 mil.
    [TR-808-Clone.kicad_pcb]
2016-02-25 all grounds routed. only unconnecteds left are through rail fitlers and SPI lines between P2 and P3
    [TR-808-Clone.kicad_pcb]
2016-02-26 tidying up a ibt. need to start placign silkscreen
    [TR-808-Clone.kicad_pcb]
2016-02-26 last commit before breaking off step switch board into separate schematic and board
    [TR-808-Clone.kicad_pcb]
2016-02-26 step switch board now separate from main board
    [TR-808-Clone.kicad_pcb, TR-808-Clone.sch, sequencer.sch, step_switch_board.kicad_pcb, step_switch_board.sch, voicing_board.sch]
2016-02-26 step switch board is done. need to work on silkscreen of main board
    [TR-808-Clone.kicad_pcb, step_switch_board.kicad_pcb]
2016-02-27 starting the long and tedious process of cleaning up the silkscreen
    [TR-808-Clone.kicad_pcb]
2016-03-01 added panel mounting holes for main board and moutning holes for step switch board
    [TR-808-Clone.kicad_pcb, step_switch_board.kicad_pcb]
2016-03-01 step switch board mounting holes added, more silkscreen clean up
    [TR-808-Clone.kicad_pcb, step_switch_board.kicad_pcb]
2016-03-01 changed snap holes to M3 holes for step switch board mounts
    [TR-808-Clone.kicad_pcb]
2016-03-01 silk screen silk screen silk screen
    [TR-808-Clone.kicad_pcb]
2016-03-03 back silkscreen basically done. little bit of tidy up left. Started on front silkscreen
    [TR-808-Clone.kicad_pcb]
2016-03-04 more silkscreen fixing and a few fixes to overlapping compoents
    [TR-808-Clone.kicad_pcb]
2016-03-04 more silkscreen refining on main board
    [TR-808-Clone.kicad_pcb]
2016-03-04 add .gitignore
    [TR-808-Clone.kicad_pcb, TR-808-Clone.sch, sequencer.sch]
2016-03-04 fixed switch board mounting hole alignment
    [TR-808-Clone.kicad_pcb, step_switch_board.kicad_pcb]
2016-03-06 bit of ground plane clean up and optimization
    [TR-808-Clone.kicad_pcb]
2016-03-06 fixed wrong oritentation of tom/conga noise switches. change made in schematic, about to import netlist and re-route
    [TR-808-Clone.sch, sequencer.sch]
2016-03-06 tom/conga noise switch fixed in schematic and PCB
    [TR-808-Clone.kicad_pcb, TR-808-Clone.sch]
2016-03-06 contga/tom switch mix up fixed. Noise input for tom was swapped with conga terminal
    [TR-808-Clone.kicad_pcb, TR-808-Clone.sch]
2016-03-06 disconnected TM4 noise level trim pot terminal 3
    [TR-808-Clone.kicad_pcb, TR-808-Clone.sch]
2016-03-06 removed incorrect junction between R44, TM1 and pin 14 of U1F, disconnected pin 3 of TM1 and TM2
    [TR-808-Clone.kicad_pcb, voicing_board.sch]
2016-03-06 done. should probably label some test points though. about to do footprint checking
    [TR-808-Clone.kicad_pcb, sequencer.sch, voicing_board.sch]
2016-03-07 main board and step switch board done. last commit before upgrading to Kicad 4.0.2
    [TR-808-Clone.kicad_pcb, step_switch_board.kicad_pcb]
2016-03-07 updated to Kicad 4.0.2 and things seem to be fine...
    [TR-808-Clone.kicad_pcb]
2016-03-08 teeny touch ups. basically ready to go.
    [TR-808-Clone.kicad_pcb]
2016-04-05 added power input protection diodes on main board, adjusted silk screen. Ordered Gerbers, shipping UPS from SEEED studio
    [TR-808-Clone.kicad_pcb, TR-808-Clone.sch, sequencer.sch, step_switch_board.kicad_pcb, voicing_board.sch]
2016-05-10 updates to schematic with build notes
    [TR-808-Clone.csv, TR-808-Clone.sch, TR-808-Clone2.csv, sequencer.sch, voicing_board.sch]
2016-07-05 started panel layout in Inkscape
    [sequencer.sch, step_switch_board.sch]
2016-07-05 working on mechanical panel layer, CH LED had horitzontal off set of +0.25mm. This has been corrected in panel drawing, but not yet corrected in PCB layout
2016-07-07 panel graphics for pattern/track mode selector
2016-07-29 Working panel file is currently Panel 2.0 background.svg, Euro TR-808 Panel .pdf and .svg were for printing to check font sizes. Need to do a file cleanup in Panel folder to get rid of unused junk
    [TR-808-Clone.sch]
2016-07-29 started version 2.0 schematic changes. Added missing R365, replaced LM13700 VCA with discrete BA662 from Open Music Labs, replaced clap and hi hat matched pairs with single NPN/PNP Qs
    [BA662.sch, TR-808-Clone.sch, sequencer.sch, voicing_board.sch]
2016-07-30 replaced MIDI/DIN sync switch with CD4052 in schematic
    [sequencer.sch]
2016-07-30 starting to think about MIDI/SYNC LED indication
    [sequencer.sch]
2016-07-31 Sync LED control pins added, tom clipping diodes changed to BAT54 with series resistor
    [BA662.sch, TR-808-Clone.sch, sequencer.sch, voicing_board.sch]
2016-07-31 updated BAT54 array schematic symobl and footprint
    [TR-808-Clone.sch]
2016-07-31 major changes to PCB started, beginning with matching hardware positions with latest panel design from Inkscape
    [Panel Template for import into Kicad.dxf, TR-808-Clone.kicad_pcb, TR-808-Clone.sch, sequencer.sch]
2016-08-01 assigning footprints before importing updated netlist into pcbnew
    [BA662.sch, TR-808-Clone.kicad_pcb, TR-808-Clone.sch, sequencer.sch, voicing_board.sch]
2016-08-01 surface mount polarized capacitors replace through hole capaictors. Updated netlist not yet imported into pcbnew
    [TR-808-Clone.sch, sequencer.sch, voicing_board.sch]
2016-08-01 first commit since importing netlist with updated footprints. Bit of a mess now. Major reroute is in order
    [TR-808-Clone.kicad_pcb, TR-808-Clone.sch, voicing_board.sch]
2016-08-02 epic pcb overhaul for 2.0 has begun. depressing
    [TR-808-Clone.kicad_pcb, TR-808-Clone.sch, voicing_board.sch]
2016-08-02 starting to make a bit of sense of this mess
    [TR-808-Clone.kicad_pcb]
2016-08-02 routing digital section
    [TR-808-Clone.kicad_pcb]
2016-08-03 more digital routing and +5V rail routing
    [TR-808-Clone.kicad_pcb]
2016-08-03 routed ISP lines more sensibly, among other things
    [TR-808-Clone.kicad_pcb]
2016-08-03 general digital routing, routed alternate ISP data lines (TRIG1, TRIG2, SYNC LED
    [TR-808-Clone.kicad_pcb]
2016-08-04 more bits and bobs of digital section routed. Bold idea: move JST GH connector to bottom side of board, near bottom edge. If this is an utter failure, then revert to this commit
    [TR-808-Clone.kicad_pcb]
2016-08-04 digital mostly done for now. step sequencer connector P2 moved to edge of board. bloody SMT electro caps have fucked up a bazillion nets with overlap by their gigantic fucking pads. slog slog slog
    [TR-808-Clone.kicad_pcb]
2016-08-04 routing routing routing. sorting out these pain in the ass SMT electro caps
    [TR-808-Clone.kicad_pcb]
2016-08-04 moving clap/maracas parts around to make room for discrete BA662 as well as for all the bloody stupid 'space-saving' SMD electro caps. fuck them dead
    [TR-808-Clone.kicad_pcb]
2016-08-05 done for the night. only 245 more connections to go...
    [TR-808-Clone.kicad_pcb]
2016-08-14 back from 1 week away. moving around clap components to make room for discrete BA662
    [TR-808-Clone.kicad_pcb]
2016-08-14 commit before going back to take a look at master branch
    [TR-808-Clone.kicad_pcb]
2016-08-14 routed discrete BA662 clone and positioned in space where LM13700 OTA was
    [TR-808-Clone.kicad_pcb]
2016-08-15 back to shuffling components to make room for SMT electro caps. boring and tedious
    [TR-808-Clone.kicad_pcb]
2016-08-15 more routing
    [TR-808-Clone.kicad_pcb]
2016-08-15 more routing in the voice board section. bloody smd caps almost done.
    [TR-808-Clone.kicad_pcb]
2016-08-16 slowly but surely. bit more to do on voicing board and also starting to sort out master section. Because master volume pot was moved, master section will need to be moved around substantially
    [TR-808-Clone.kicad_pcb]
2016-08-16 about to move master out components and reroute. Need to replace step switch board mounting holes, which were deleted in last netlist import
    [TR-808-Clone.kicad_pcb]
2016-08-17 routing master secton. Looking good. Going to try to flip summing resistors to bottom side of board
    [TR-808-Clone.kicad_pcb]
2016-08-17 master routed, power on mute still needs to be routed, Q13 is reasonably placed, so that's a good start
    [TR-808-Clone.kicad_pcb]
2016-08-17 master section including power on mute is routed. time to sort out trigger connectors
    [TR-808-Clone.kicad_pcb]
2016-08-17 bit of fiddling before sorting out trigger connectors
    [TR-808-Clone.kicad_pcb]
2016-08-18 changed trigger connectors to 3 x 6 position JST GH series, pending cable assembly availabilty. Commit before importing netlist
    [TR-808-Clone.kicad_pcb, TR-808-Clone.sch, sequencer.sch]
2016-08-18 2/3 of trigger connectors routed. starting to stitch ground plane
    [TR-808-Clone.kicad_pcb]
2016-08-18 reconfigured trigger connectors and routed. Now just power and ground left
    [TR-808-Clone.kicad_pcb, sequencer.sch]
2016-08-19 adjusting panel document and pcb to cooridinate pcb panel mounting screws
    [TR-808-Clone.kicad_pcb]
2016-08-20 removed SW3 from schematic and PCB. more fiddling with panel mounting screws
    [TR-808-Clone.kicad_pcb, sequencer.sch]
2016-08-20 grounds all stitched. just nee to check unconnected 12V rails
    [TR-808-Clone.kicad_pcb]
2016-08-20 bit of fiddling with ground planes. About to redo ground planes to separate analogue and digital realms
    [TR-808-Clone.kicad_pcb]
2016-08-20 last commit before separating ground planes
    [TR-808-Clone.kicad_pcb]
2016-08-23 ground plane now split into analog and digital regions. More stitching required and then need to decide how to link them up. Also, schematic has U28 unused inputs now grounded as these were oscillati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
    [TR-808-Clone.kicad_pcb, sequencer.sch]
2016-08-23 fiddling with ground fills. going to adjust ground plane outlines again
    [TR-808-Clone.kicad_pcb]
2016-08-24 stitching. still need to reshape ground plane along bottom of board to provide nice return path for analog master section
    [TR-808-Clone.kicad_pcb]
2016-08-24 adjusted ground planes to provide fat juicy return path for analog section
    [TR-808-Clone.kicad_pcb]
2016-08-24 routed, yo. Still need to check 12V supply rails throughout
    [TR-808-Clone.kicad_pcb]
2016-08-25 more ground plane optimization, starting to update 3D component models
    [TR-808-Clone.kicad_pcb]
2016-08-25 updated 3D components for JST GH connectors and TC33X trimmers
    [TR-808-Clone.kicad_pcb]
2016-08-25 more 3D model updating. B3W 4050 adapter assembly now included, although vrml output from Kicad is messed up and required editing of vrml file to get 4050 the right orientation and scale. possible Ki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
    [B3W-4050-adapter.kicad_pcb, B3W-4050-adapter.sch, TR-808-Clone.kicad_pcb]
2016-08-26 starting to clean up silkscreen
    [TR-808-Clone.kicad_pcb]
2016-08-26 very boring and tedious silkscreen editing
    [TR-808-Clone.kicad_pcb]
2016-08-26 maybe 50% done bottom copper silkscreend editing
    [TR-808-Clone.kicad_pcb]
2016-08-27 silkscreen clean up
    [TR-808-Clone.kicad_pcb]
2016-09-01 almost done silkscreen reference placement
    [TR-808-Clone.kicad_pcb]
2016-09-02 silkscreen pretty much done front adn back. tweaked top ground plane a bit for greater coninuity and flow
    [TR-808-Clone.kicad_pcb]
2016-09-03 more silkscreen tweaking and attempt at dxf logo
    [Rhythm_composer_text.dxf, TR-808-Clone.kicad_pcb]
2016-09-03 made dxf alignment templates and checked against panel mechanical drawing. all checked out except 0.5 vertical offset on switch board holes. Fixed.
    [79logo.dxf, Panel 2.0 alignment template.dxf, TR-808-Clone.kicad_pcb, step_switch_board.kicad_pcb]
2016-09-04 getting close to plotting gerbers. Time for comprehensive DRC
    [TR-808-Clone.kicad_pcb]
2016-09-04 boom, clean DRC. 13 unconnected pads due to filtered rails for each voice
    [TR-808-Clone.kicad_pcb]
2016-09-05 tiny bit of ground plane optimization. DRC clean.
    [TR-808-Clone.kicad_pcb]
2016-09-07 changed switchboard connector to Molex FFC connector. Hopefully this is a good idea
    [TR-808-Clone.kicad_pcb]
2016-09-08 logo update, step switch board tweaking, main board ground plane tweaking. Should be ready for fabrication. Just need to do a footprint check
    [79logo.dxf, TR-808-Clone.kicad_pcb, step_switch_board.kicad_pcb]
2016-09-09 more ground plane tweaking. Need to take a look at pot mounting studs - they probably need more clearance because song huei pots have larger landing base
    [TR-808-Clone.kicad_pcb]
2016-09-09 added landing pads for song huei pot studs on top copper
    [TR-808-Clone.kicad_pcb]
2016-09-10 changed 3D models for OMRON 4050 switch assembly
    [B3W-4050-adapter.kicad_pcb, Panel_2.0_mechanical.dxf, TR-808-Clone.kicad_pcb]
2016-09-14 now that 3D rendering with panel is in full swing a few small changes to panel cutout sizes need to be made to accommodate panel maker's 0.01 inch tolerance
    [TR-808-Clone.kicad_pcb]
2016-09-14 more tweaking of panel cutouts. Also changed DIN jack footprint to allow counter sinking
    [TR-808-Clone.kicad_pcb]
2016-09-14 added legend to panel to allow pattern bank switching
    [TR-808-Clone.kicad_pcb]
2016-09-16 moved MIDI LED indicator down 0.125 mm for consistent LED to hole spacing. Tweaked pot holes, step switch cutouts, 5 mm e-switch cap holes.
    [Panel_2.0_mechanical.dxf, TR-808-Clone.kicad_pcb]
2016-09-16 added readme.md
    [Panel_2.0_mechanical.dxf, TR-808-Clone.kicad_pcb]
2016-09-16 final ground stitching before ordering v2.0
    [TR-808-Clone.kicad_pcb]
2016-09-16 one last fiddle, elminated bottleneck in ground plane
    [TR-808-Clone.kicad_pcb]
2016-09-17 panelizing 4050 switch adapter pcb
    [B3W-4050-adapter.kicad_pcb, TR-808-Clone.kicad_pcb, step_switch_board.kicad_pcb]
2016-09-17 finished panelizing 4050 switch adapter board
    [B3W-4050-adapter.kicad_pcb]
2016-09-19 4050 adapter board done. Just realized the MIDI in/out is fucked all to hell and designed by an idiot. Needs a complete overhaul, starting now
    [B3W-4050-adapter.kicad_pcb]
2016-09-20 changed MIDI circuitry. supports DIN SYNC IN/OUT and MIDI IN, no out. MIDI TX and remaining DIN lines broken out to 4 pin JST GH connector
    [TR-808-Clone.kicad_pcb, sequencer.sch]
2016-09-20 MIDI/SYNC updates routed, DRC pass with exception of slots in pads on X1
    [TR-808-Clone.kicad_pcb]
2016-09-20 main board rev2 ordered, step switch board r1.1 ordered, 4050 switch adapter boards ordered. gulp.
    [TR-808-Clone.kicad_pcb]
2016-10-29 changed all NPN and PNPs to 945 and 733 respectively
    [TR-808-Clone.kicad_pcb, TR-808-Clone.sch, voicing_board.sch]
2016-11-02 few part value format edits to get better fiting
    [TR-808-Clone.kicad_pcb]
2016-11-03 added notes about C119/C117 in RS/CL circuit. Fixed missing +12V via that was depriving R321 of +ve rail
    [TR-808-Clone.kicad_pcb, TR-808-Clone.sch]
2016-11-08 more corrections and adjustments based on assembly
    [TR-808-Clone.kicad_pcb, voicing_board.sch]
2017-01-29 updated readme, changed a few things
    [TR-808-Clone.kicad_pcb, sequencer.sch]
2017-02-13 made some notes on schematics. added beginnings of OM
    [sequencer.sch, voicing_board.sch]
2017-03-24 added 47uF caps to 5V supplies for U37 and U37. required to reduce SPI noise
    [TR-808-Clone.kicad_pcb, sequencer.sch]
2017-03-29 about to swap individal trigger headers to one single 20 pin trigger header
    [TR-808-Clone.kicad_pcb]
2017-03-29 all triggers consolidated into one connector
    [TR-808-Clone.kicad_pcb, sequencer.sch]
2017-04-06 fiddling with panel. 2x10 1.27mm pitch trigger connector routed
    [TR-808-Clone.kicad_pcb, TR-808-Clone.sch, sequencer.sch, voicing_board.sch]
2017-04-13 added 5V to 12V selectable trigger output for TRIG OUT 2
    [TR-808-Clone.sch, sequencer.sch, voicing_board.sch]
2017-04-28 update readme, add system 80 logo
    [TR-808-Clone.sch, voicing_board.sch]
2017-05-02 few tweaks, ready to generate gerbers for 2.1 production prototype
    [TR-808-Clone.sch, sequencer.sch, voicing_board.sch]
2017-05-02 pcbs ordered. forgot to update X1 footprint. fixed now
2017-05-02 more X1 updates - plated slots
2017-06-20 panel stuff plus changed C12 footprint
    [Panel_2.0_mechanical_r12.dxf, Panel_2.0_mechanical_r2000.dxf, TR-808-Clone.csv]
2017-10-16 added input protection fuses, fixed trigger level converter, few tweaks
    [TR-808-Clone.sch, sequencer.sch]
2017-10-19 changed C126 footprint, moved Q69 so it doesn't overlap with D69
    [TR-808-Clone.sch, voicing_board.sch]
2017-10-19 added fiducials. about to panelize
    [step_switch_board.kicad_pcb]
2017-10-21 changed P3 trigger expander connector, added TRIG signal to expander connector, twiddled and diddled traces and ground plane
    [880-mainboard.csv, 880-switchboard.csv, TR-808-Clone.sch, panelized.csv, sequencer.sch, voicing_board.sch]
2017-10-21 updated readme, few tweaks, updated footprints in schematic to match pcb
    [sequencer.sch]
2017-10-25 changed R values in main board that were duplicated in switch board, few tweaks
    [TR-808-Clone.sch, sequencer.sch, voicing_board.sch]
2017-10-31 panelizing, added V-CUT lines, which need to be moved to edge cut layer when generating gerbers
    [TR-808-Clone.sch]
2017-11-02 0603 footprints changed to 0.8 x 0.8 mm from 0.8 x 1.1
2017-11-02 panelized production prototype PCB sent for fabrication
2018-04-17 some work on the Manual
    [TR-808-Clone.sch, sequencer.sch]
2018-05-02 beginning of 4 layer conversion
    [TR-808-Clone.sch]
2018-05-02 added extra RC filter on mix out circuit
    [TR-808-Clone.sch, sequencer.sch, voicing_board.sch]
2018-05-03 redo of power routing complete
2018-05-03 adjusted bottom ground plane, completely split now. starting to change 12V names to account for RC isolation
    [TR-808-Clone.sch]
2018-05-03 updated rail labelling 0 unconnected with new labelling
    [TR-808-Clone.sch, sequencer.sch, voicing_board.sch]
2018-05-04 added larger bypass caps to switch board, adding coupling caps to critical op amps
    [TR-808-Clone.sch, sequencer.sch, step_switch_board.kicad_pcb, step_switch_board.sch, voicing_board.sch]
2018-05-04 added ferrite beads on rail inputs, routed
    [TR-808-Clone.sch, sequencer.sch, voicing_board.sch]
2018-05-04 reconfigured master output summer resistor layout
    [TR-808-Clone.sch, sequencer.sch, voicing_board.sch]
2018-05-06 few spi routing tweaks
2018-05-07 fixed duplicate reference between main board and switch board
    [TR-808-Clone.sch]
2018-05-09 added 2 extra standoff holes to switch board and main board, updated switch board to 4 layer
    [sequencer.sch, step_switch_board.kicad_pcb]
2018-05-09 added backup LM4040 as alternative to Q9 voltage source
    [step_switch_board.kicad_pcb, voicing_board.sch]
2018-05-09 updated jack footprints with keepout lines around metal frame landing areas
2018-05-09 updated panelized board with new main board and switch board layouts
2018-05-10 updated 0603 R and C footprints in panelized.kicad_pcb
2018-05-15 added two extra standoffs to support span between switch board
2018-05-31 added .pos file for diff to 2 layer branch
    [sequencer.sch]
2018-07-07 added proper DIN input protection to schematic, still needs placing and routing
    [panelized.csv, sequencer.sch, voicing_board.sch]
2018-07-07 DIN and trigger pins have secondary protection now. implemented in board and schematic, routed - panelized board only
    [sequencer.sch]
2018-08-09 working on manual again
    [sequencer.sch]
2018-08-22 BA662 matched pair footprints changed to SOT-666 from SOT-363 due to availability issues
2018-08-27 serial number squares added to PCB, more manual work
2018-09-05 final touches on panelized PCB before ordering
2018-09-10 working on back cover panel
    [back_panel.kicad_pcb]
2018-09-11 almost done first version of back panel
    [back_panel.kicad_pcb]
2018-09-14 back panel design almost done
    [back_panel.kicad_pcb]
2018-09-20 production PCBs ordered, working on manual
    [back_panel.kicad_pcb]
2018-09-30 more manual work, about to resize front panel diagram to A4
    [TR-808-Clone.sch]
2018-10-31 added operation rerference page to manual, added a couple of notes about clap reverb changes
    [TR-808-Clone.sch, back_panel.kicad_pcb]
2018-11-02 updates to back panel
    [back_panel.kicad_pcb]
2018-11-02 more back panel work
    [back_panel_backup.kicad_pcb]
2018-11-26 update manual
    [back_panel.kicad_pcb]
2018-11-28 removed mask on back panel grid
    [back_panel.kicad_pcb]
2018-12-16 more manual updating before sending to print
    [back_panel.kicad_pcb]
2019-01-22 adding new mounting holes in panelized PCB to accomodate concealed standoffs in next revision panel
2019-01-22 doh, left on R unconnected when moving mounting hole. connecged now
2019-09-27 ummmmm. v1.5 hopefully. date and version changed. need to doublecheck hex standoff hole diameters. about to try splitting grounds in a new branch.
    [cutout.kicad_pcb]
2019-09-27 changed all grounds in digital section to GNDD
    [TR-808-Clone.sch, sequencer.sch]
2019-09-27 digital and analog grounds now separated in schematic, need to apply to PCB
    [TR-808-Clone.sch, sequencer.sch]
2019-09-28 tweaking ground planes. need to link analog and digital at power input
    [TR-808-Clone.sch]
2019-10-01 added vias where necessary, down to dealing with grounding two input filter caps, need to doublecheck drc for shorts between GNDA and GNDD
2019-10-01 planes split, joined at power connector
    [TR-808-Clone.sch]
2019-10-09 adding some judicious power planes
2019-10-16 thicken up +V tracks into power plane fills
2019-10-17 more planing of rails
2019-10-18 finished planing negative rail
2019-10-29 tweaked 5V rail, passed DRC test for everything but mixed grounds
2019-10-29 gerbers exported for split
2020-02-02 changes to back panel for B series run
    [back_panel.kicad_pcb]
2020-02-04 ordered back panels, just updated text
    [back_panel.kicad_pcb]
